ZR-OIT/senior-project/CST 472 - Winter/images/Trello after changes part 2 1-12-2021.png

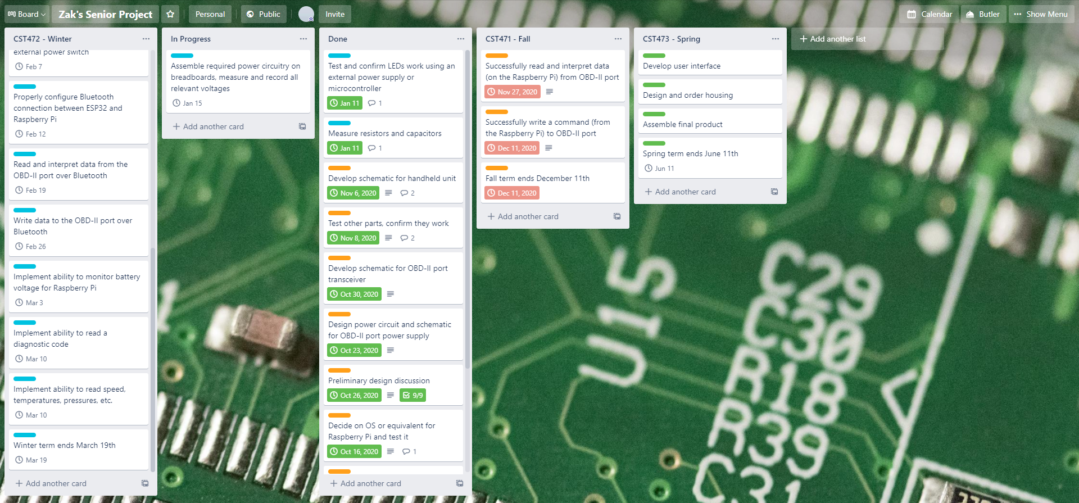
CST 472 - Winter/images/Trello after changes part 2 1-12-2021.png
