ZR-OIT/senior-project/CST 472 - Winter/images/Trello after building circuit.png

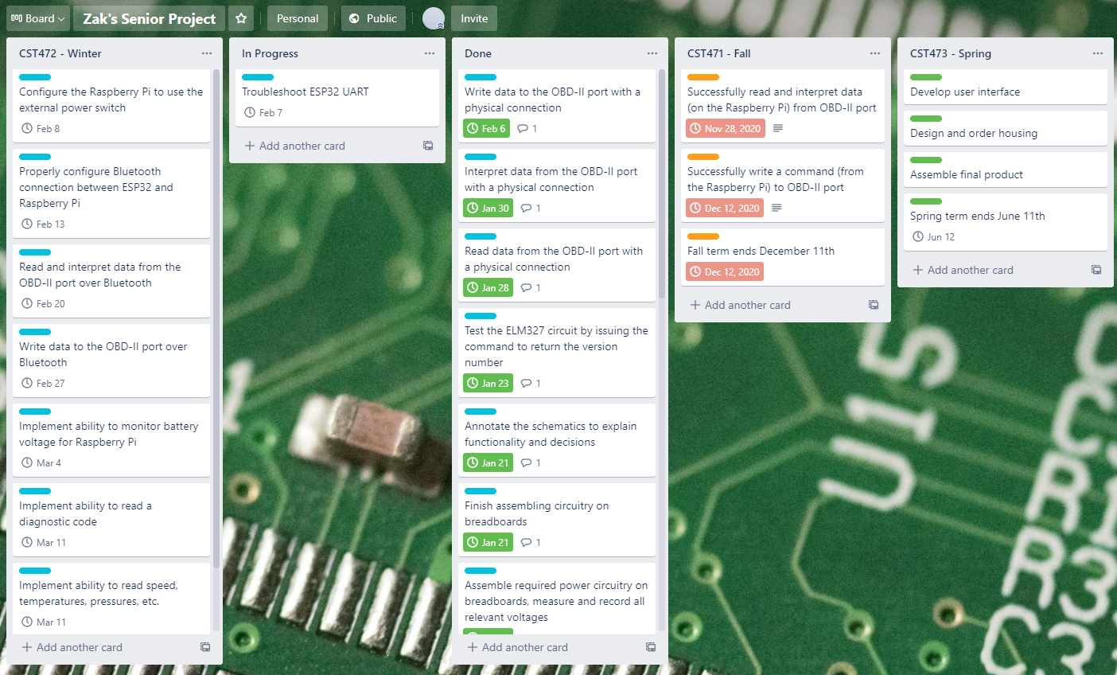
CST 472 - Winter/images/Trello after building circuit.png
