ZR-OIT/senior-project/README.md

# senior-project
My senior project for Oregon Institute of Technology - A touchscreen Bluetooth OBD-II diagnostic tool.
