ZR-OIT/senior-project/CST 472 - Winter/Memo 1.pdf

## CST 472

# Memo

To: | Kevin Pintong
From: | Zak Rowland
Date: | January 23, 2021
Re: | Memo 1

After last term ended, I wasn’t working on the project for almost a month as I was visiting family. Once the term started again, I would dive back into the project. But, motivation has been extremely hard to come by, and not just in this class. The first thing I worked on was testing resistors and capacitors with a multimeter as well as the LEDs and push button. The push button I got for the Pi has a LED built in, so I tested the external LEDs using this button and an Arduino for power.

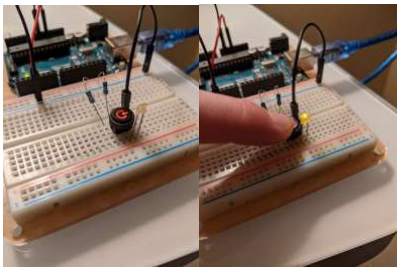
[picture p71: figure]

While testing and looking through my parts, I realized I forgot to order surface-mount to dualinline-pin adapters for my small ICs that will allow me to breadboard the circuit easier, so I ordered some. After meeting with you and discussing my schematic, I changed the 5V regulator to use a bigger input capacitor and began assembling the power delivery portions of the circuit. I built and tested the 12V to 5V circuitry first which worked as expected. I also attached breadboard wires to my OBD-II connector.

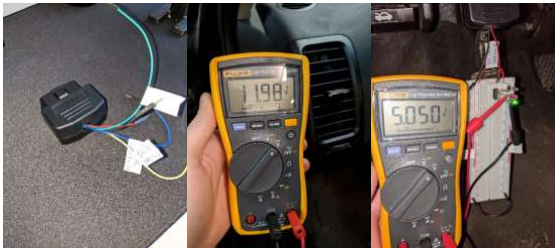
[picture p72: figure]

Once I had 5V power, I added and tested the 3.3V circuitry which also worked as expected.

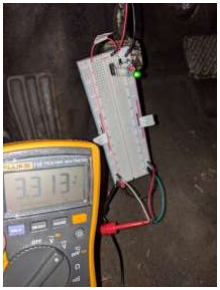
[picture p73: figure]

After I had the power circuitry, I began assembling the rest of the circuit. Once the SMD to DIP adapters came, I soldered them together with the ICs. I had trouble at first soldering the legs of the tiny 8-pin package (I used too much solder,) but eventually got the first side soldered and the other side went much smoother. The excess heat from messing up could have damaged the IC but it is unlikely.

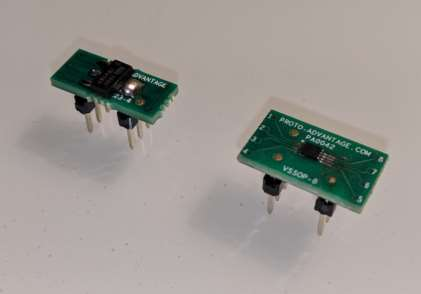
[picture p74: figure]

While building the circuit, I annotated the schematic to make sure myself and others understand how it functions and what things are for.

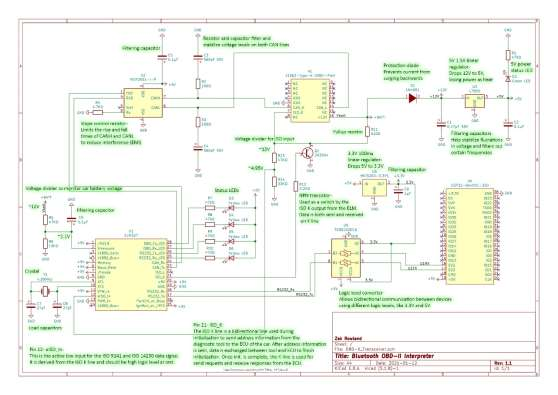
[picture p75: figure]

Once the circuit was assembled, I tried to test the ELM327 by reading the version number through a terminal. I used the UART of the ESP32 using the correct settings, however the data being read is complete gibberish, so I cannot confirm the circuit works yet. One good sign is that the four status LEDs light up in sequence when power is provided to the circuit, which as explained in the ELM327 datasheet means the chip is initializing.

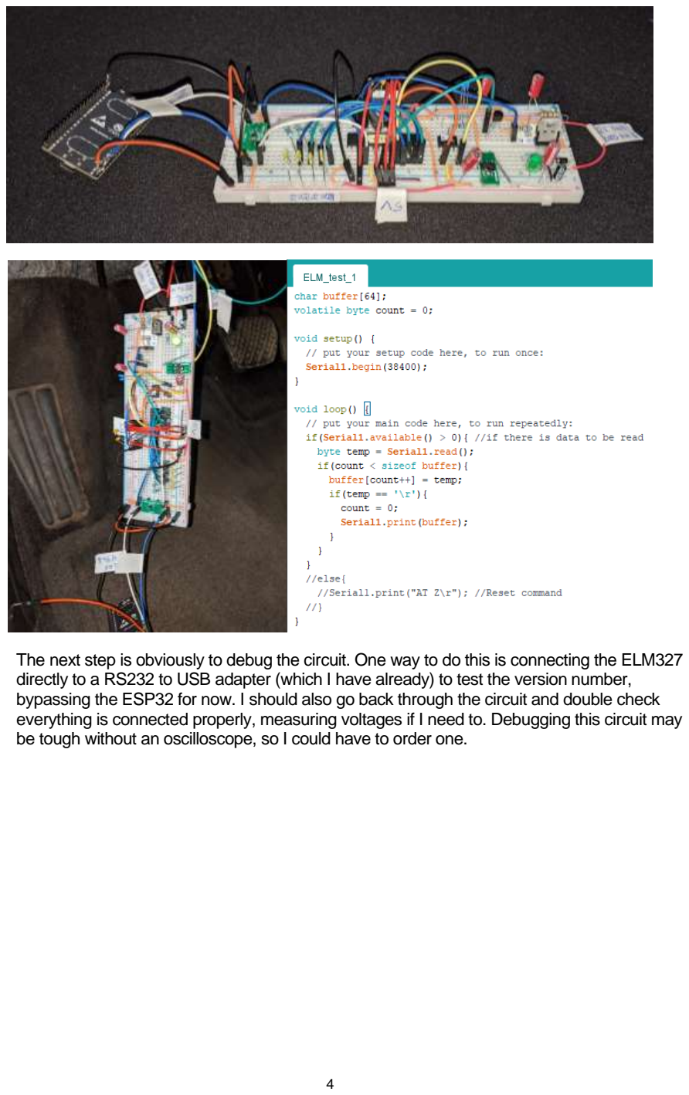
[picture p76: page 4]

The next step is obviously to debug the circuit. One way to do this is connecting the ELM327 directly to a RS232 to USB adapter (which I have already) to test the version number, bypassing the ESP32 for now. I should also go back through the circuit and double check everything is connected properly, measuring voltages if I need to. Debugging this circuit may be tough without an oscilloscope, so I could have to order one.

Hours worked since term start: 14

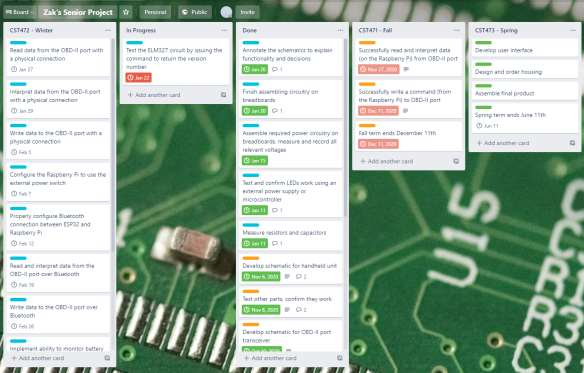
[picture p77: figure]

https://trello.com/b/57kp2fr0/zaks-senior-project
