ZR-OIT/senior-project/CST 374 - Proposal/Senior Project Gantt.xlsx

Wireless OBD-II Diagnostic Tool with Touchscreen
Select a period to highlight at right. A legend describing the charting follows. |  |  |  |  | Period Highlight: | 2 |  |  | Plan Duration |  |  |  |  |  | Actual Start |  |  |  |  | % Complete |  |  |  |  | Actual (beyond plan) |  |  |  |  |  |  |  | % Complete (beyond plan)
ACTIVITY | PLAN START | PLAN DURATION | ACTUAL START | ACTUAL DURATION | PERCENT COMPLETE | 2020-05-01 | 2020-06-01 | 2020-07-01 | 2020-08-01 | 2020-09-01 | 2020-10-01 | 2020-11-01 | 2020-12-01 | 2021-01-01 | 2021-02-01 | 2021-03-01 | 2021-04-01 | 2021-05-01 | 2021-06-01
 |  |  |  |  |  | 1 | 2 | 3 | 4 | 5 | 6 | 7 | 8 | 9 | 10 | 11 | 12 | 13 | 14 | 15 | 16 | 17 | 18 | 19 | 20 | 21 | 22 | 23 | 24 | 25 | 26 | 27 | 28 | 29 | 30 | 31 | 32 | 33 | 34 | 35 | 36 | 37 | 38 | 39 | 40 | 41 | 42 | 43 | 44 | 45 | 46 | 47 | 48 | 49 | 50 | 51 | 52 | 53
Documentation | 1 | 14 | 1 | 2 | 10%
Requirements Development | 1 | 5 | 1 | 2 | 80%
Research | 2 | 12 | 2 | 1 | 10%
Develop OBD-II Port Module | 4 | 10 | 0 | 0 | 0%
Testing | 5 | 10 | 0 | 0 | 0%
Develop Handheld Unit | 6 | 8 | 0 | 0 | 0%
Develop User Interface | 8 | 7 | 0 | 0 | 0%
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
