ZR-OIT/senior-project/CST 471 - Fall/images/Handheld Transceiver Schematic-1.jpg

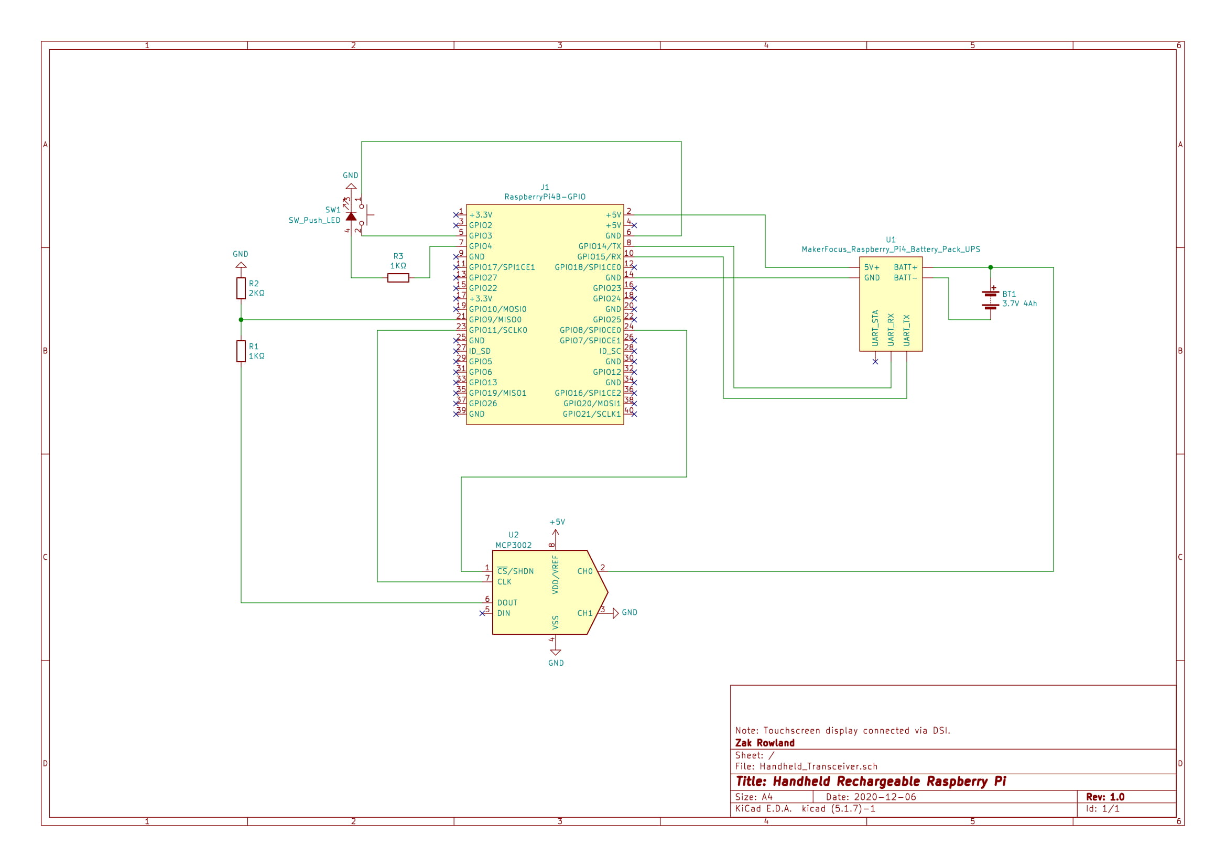
CST 471 - Fall/images/Handheld Transceiver Schematic-1.jpg
