ZR-OIT/senior-project/CST 471 - Fall/images/obd2 port pinout.png

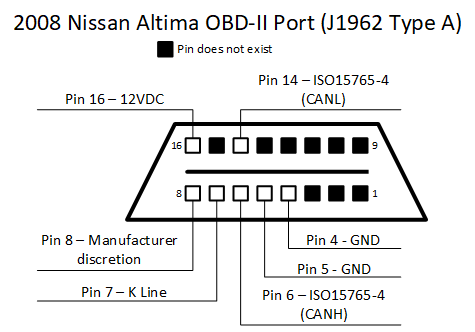
CST 471 - Fall/images/obd2 port pinout.png
