ZR-OIT/senior-project/CST 471 - Fall/images/OBD2.png

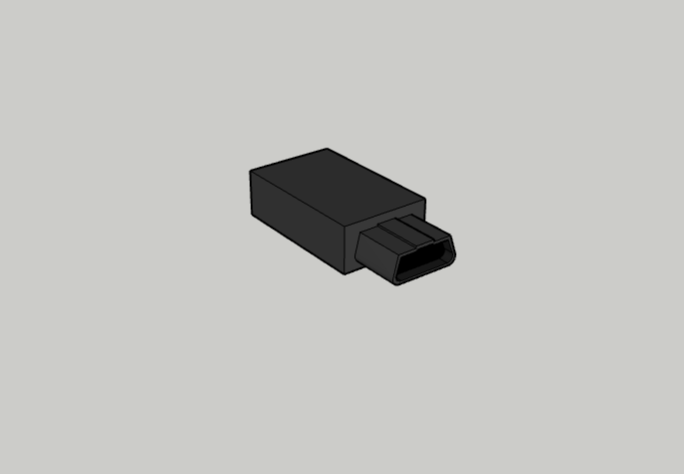
CST 471 - Fall/images/OBD2.png
