ZR-OIT/senior-project/CST 471 - Fall/images/screen.jpg

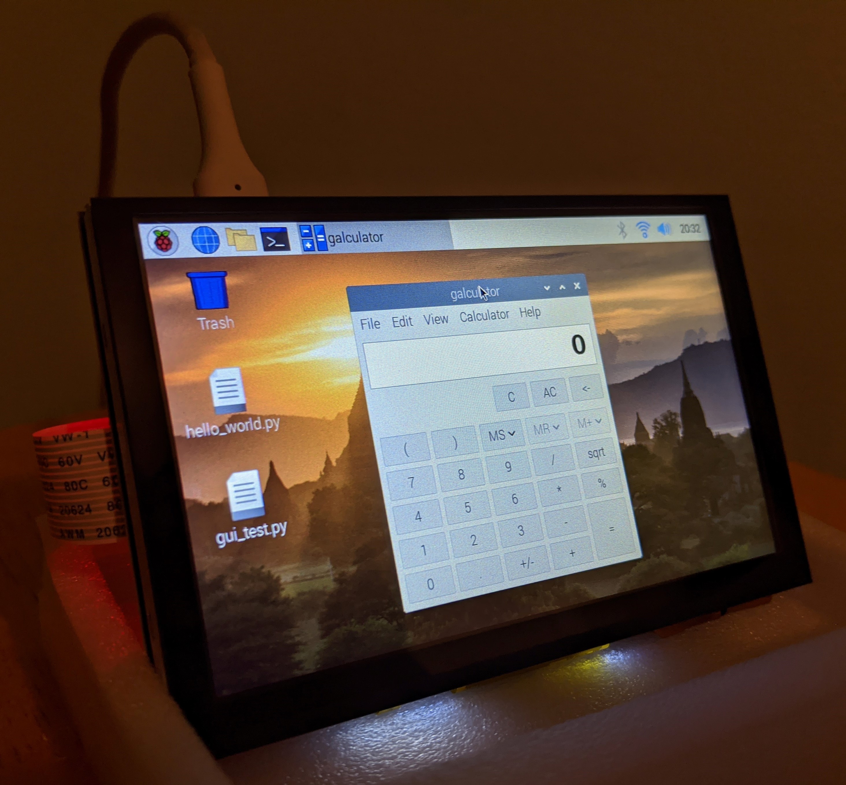
CST 471 - Fall/images/screen.jpg
