ZR-OIT/senior-project/CST 472 - Winter/images/3-8-2021 ble phone app.png

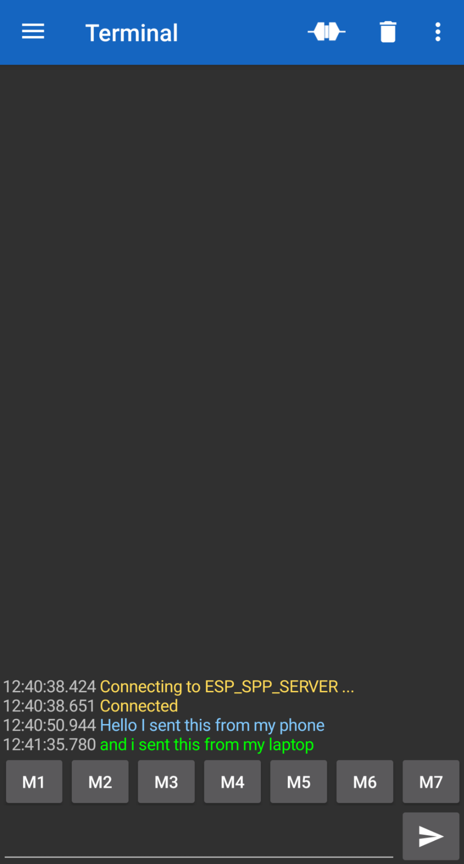
CST 472 - Winter/images/3-8-2021 ble phone app.png
