ZR-OIT/senior-project/CST 472 - Winter/images/3-8-2021 esp server info.png

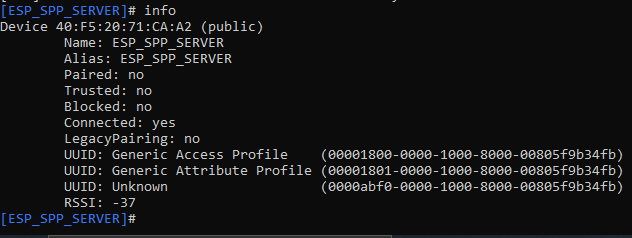
CST 472 - Winter/images/3-8-2021 esp server info.png
