ZR-OIT/senior-project/CST 472 - Winter/images/3-8-2021 pairing esp to pi from terminal.png

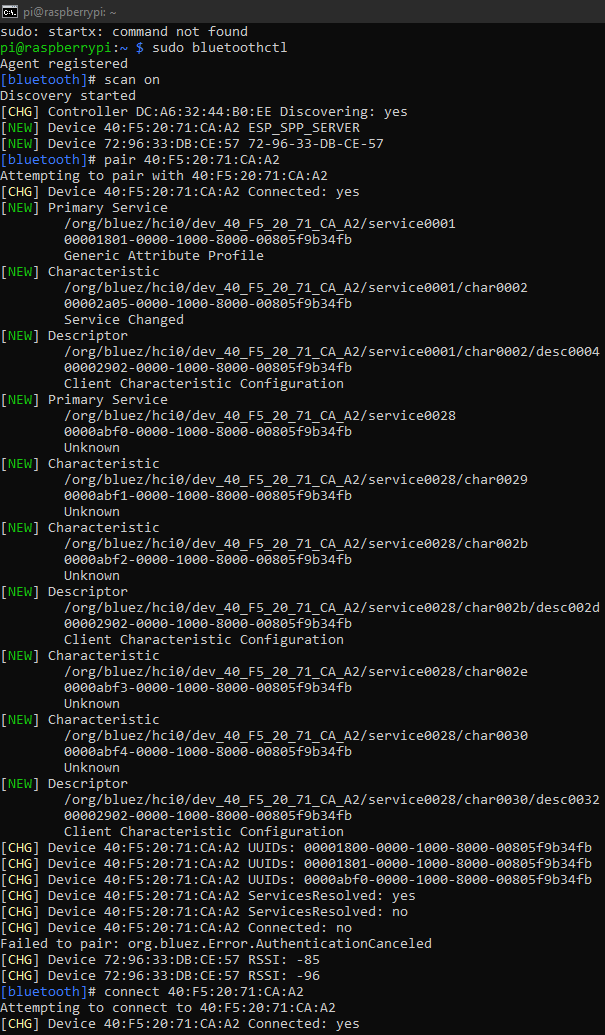
CST 472 - Winter/images/3-8-2021 pairing esp to pi from terminal.png
