ZR-OIT/senior-project/CST 472 - Winter/images/3-9-2021 trello.png

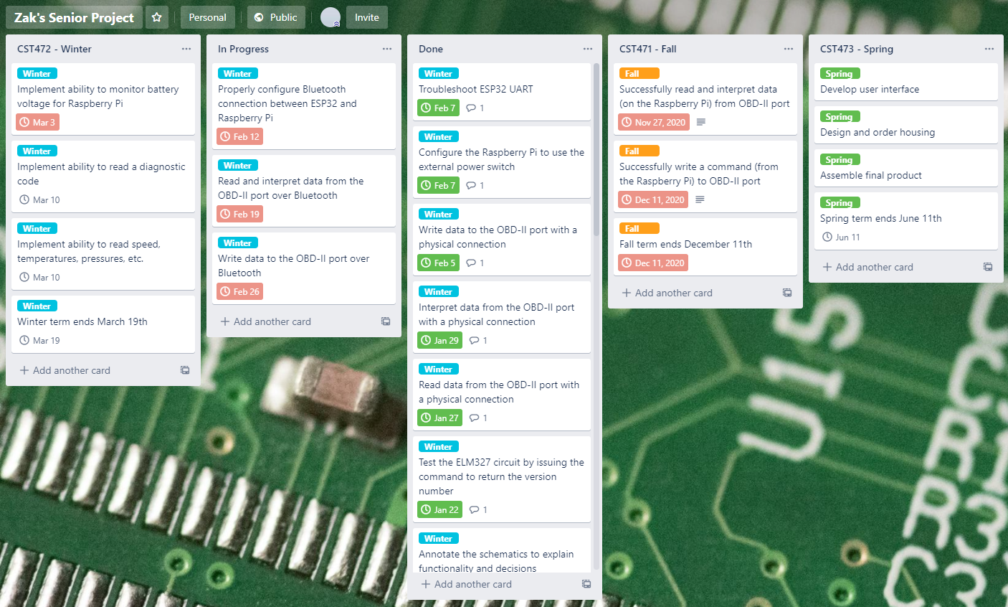
CST 472 - Winter/images/3-9-2021 trello.png
