ZR-OIT/senior-project/CST 472 - Winter/images/3-28-2021-UPS1.jpg

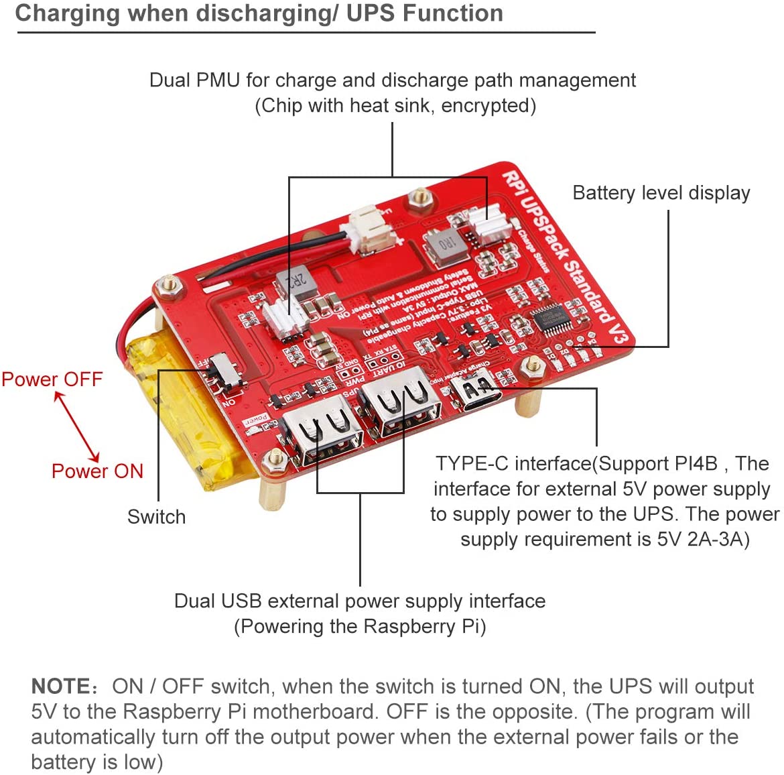
CST 472 - Winter/images/3-28-2021-UPS1.jpg
