ZR-OIT/senior-project/CST 472 - Winter/images/ELM other commands.png

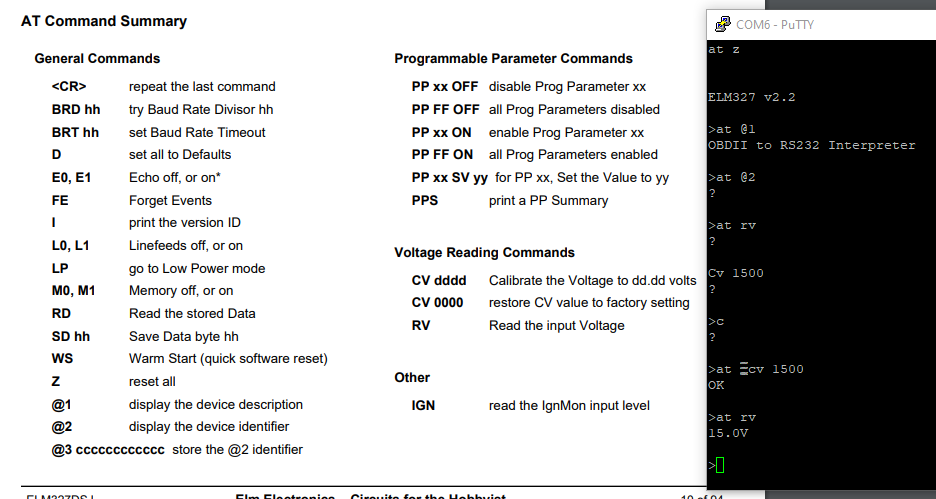
CST 472 - Winter/images/ELM other commands.png
