ZR-OIT/senior-project/CST 472 - Winter/images/Gibberish data through ESP.png

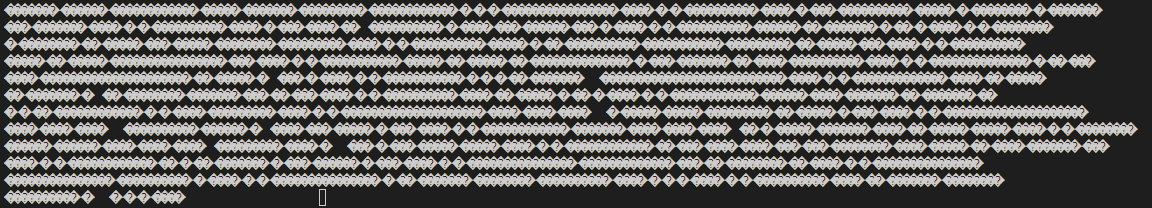
CST 472 - Winter/images/Gibberish data through ESP.png
