ZR-OIT/senior-project/CST 472 - Winter/images/PXL_20210112_045008964.jpg

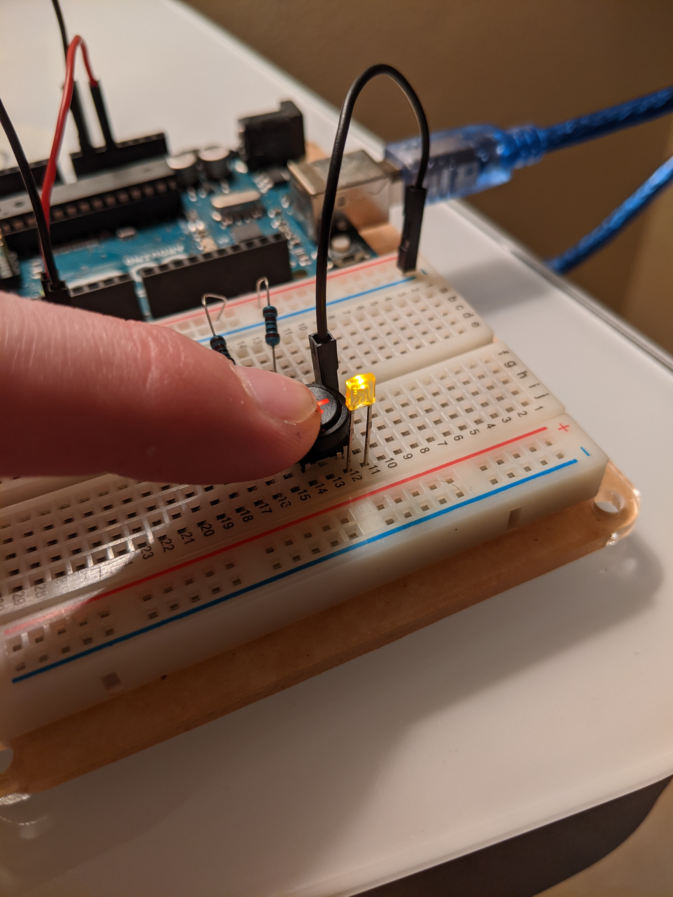
CST 472 - Winter/images/PXL_20210112_045008964.jpg
