ZR-OIT/senior-project/CST 472 - Winter/images/PXL_20210121_015945303.jpg

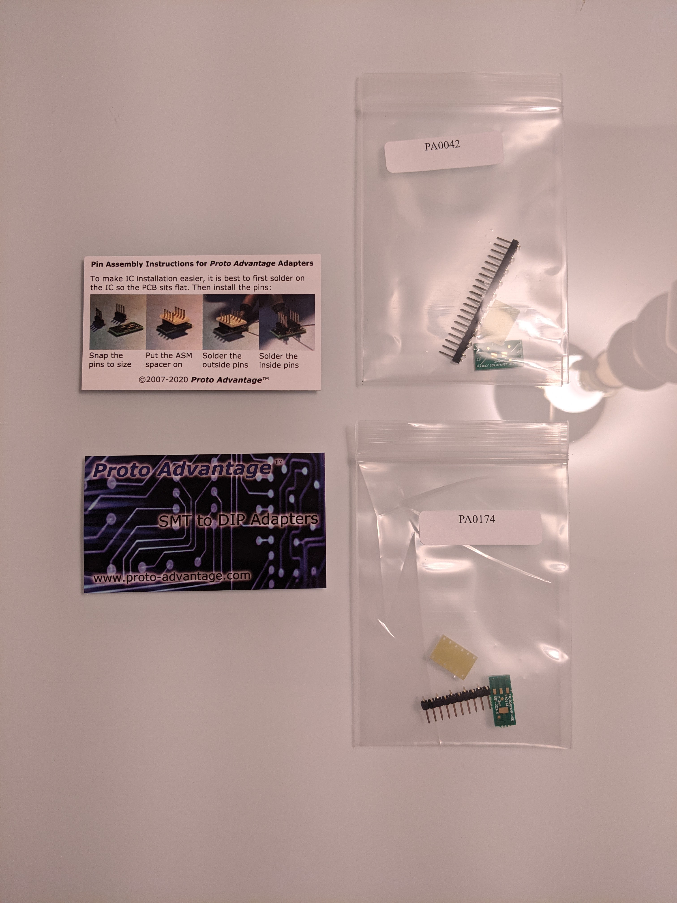
CST 472 - Winter/images/PXL_20210121_015945303.jpg
