ZR-OIT/senior-project/CST 472 - Winter/images/PXL_20210121_030754074.jpg

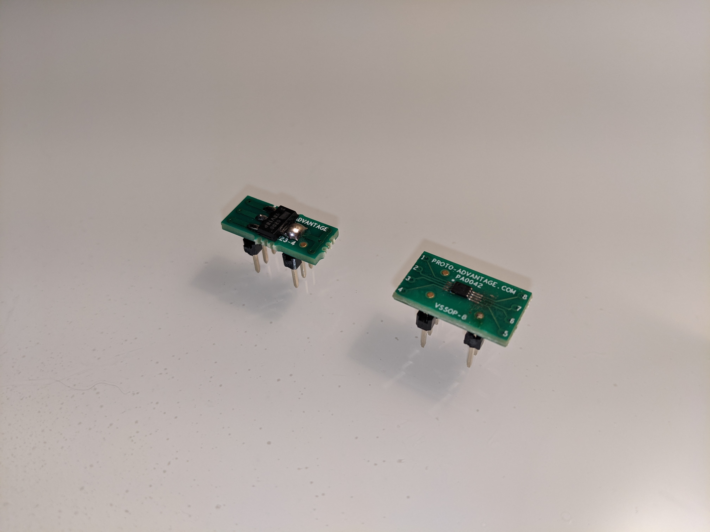
CST 472 - Winter/images/PXL_20210121_030754074.jpg
