ZR-OIT/senior-project/CST 472 - Winter/images/PXL_20210215_024756749_esp32-3V-out.jpg

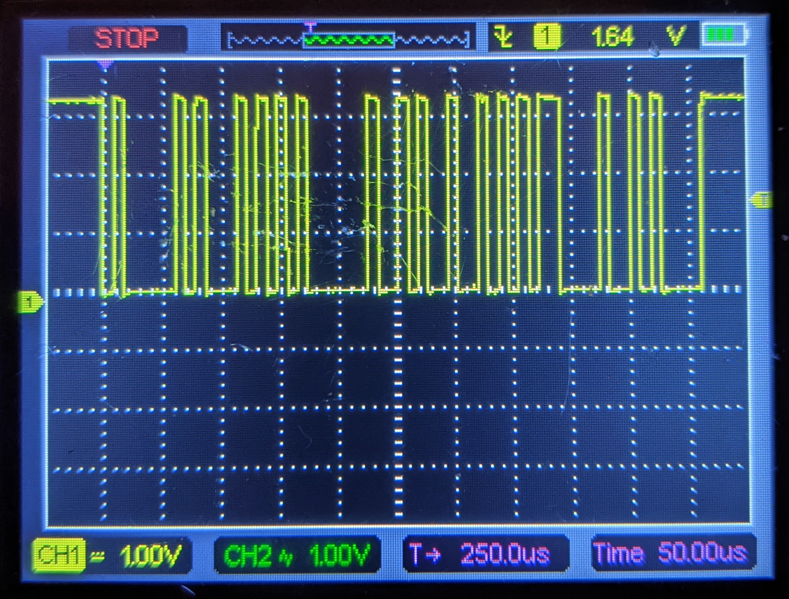
CST 472 - Winter/images/PXL_20210215_024756749_esp32-3V-out.jpg
