ZR-OIT/senior-project/CST 472 - Winter/images/PXL_20210215_025533629_signal-after-3V-to-5V-conversion.jpg

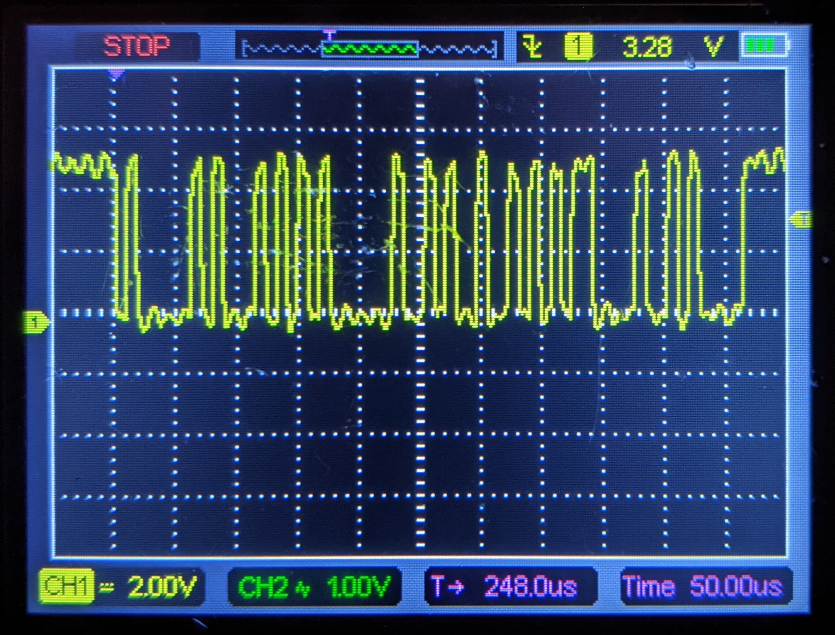
CST 472 - Winter/images/PXL_20210215_025533629_signal-after-3V-to-5V-conversion.jpg
