ZR-OIT/senior-project/CST 472 - Winter/images/talking to car 2.png

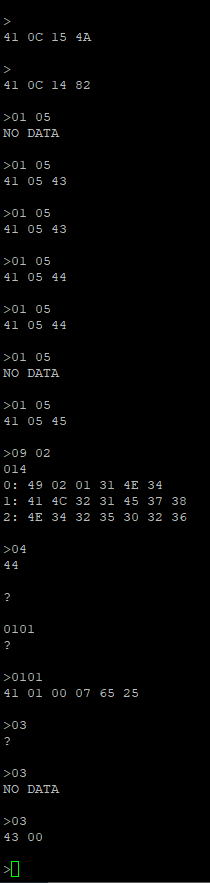
CST 472 - Winter/images/talking to car 2.png
