ZR-OIT/senior-project/CST 473 - Spring/Touchscreen GUI.jpg

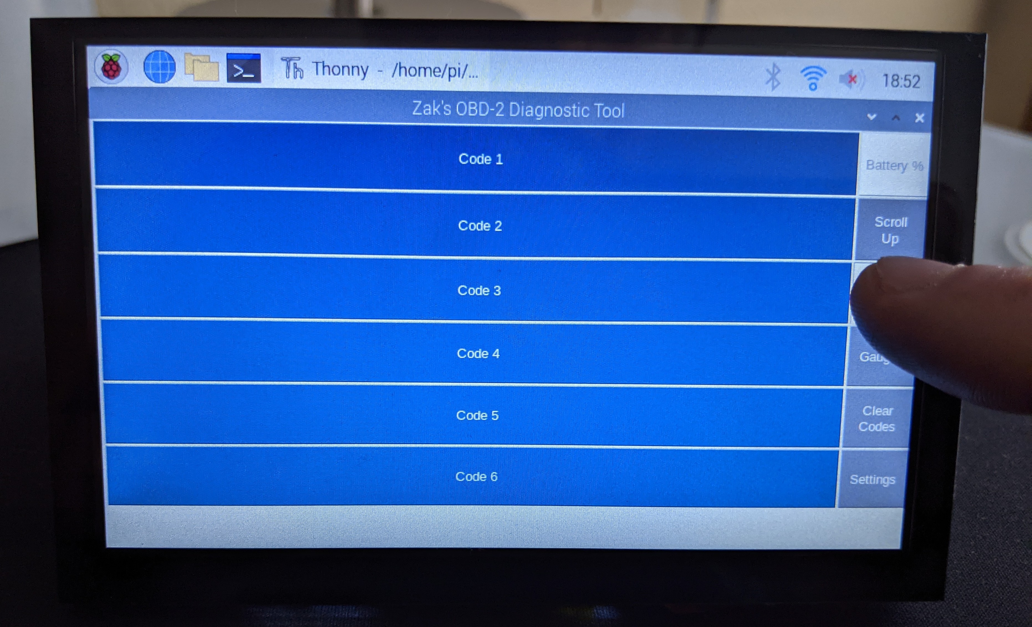
CST 473 - Spring/Touchscreen GUI.jpg
