ZR-OIT/senior-project/CST 471 - Fall/Parts Table - Created 10-3-2020.xlsx

Zak Rowland's Senior Project Part List - Last Updated 12/6/2020
Handheld Module | Part Name: | Links to Buy: | Cost Each: | Quantity: | Spares: | Shipping Cost: | Total Cost: | Purchased: | Datasheets: | Total Parts Cost: | $114.80
 | Raspberry Pi 4 (Model B) | https://www.adafruit.com/product/4292 | $35.00 | 1 | 0 | $0.00 | $0.00 | Already had. | https://www.raspberrypi.org/documentation/ | Total Parts Cost with Shipping: | $124.64
 | OSOYOO 5" DSI Display | https://www.amazon.com/gp/product/B07KKB5YS9 | $43.88 | 1 | 0 | $0.00 | $43.88 | Yes | N/A | Total Parts Cost to Me: | $89.44
 | MakerFocus Raspberry Pi 4 Battery Pack UPS | https://www.amazon.com/dp/B01LAEX7J0/ | $23.99 | 1 | 0 | $0.00 | $23.99 | Yes | https://drive.google.com/file/d/12_UCy6u5iaznpgSu-4YFTY0w-D2REM_4/view | Total Parts Cost to Me with Shipping: | $99.28
 | Momentary Switch | https://www.adafruit.com/product/3104 | $1.95 | 1 | 0 | $4.85 | $6.80 | Yes | https://cdn-shop.adafruit.com/product-files/3104/C4819+datasheet.pdf | Total Shipping Cost: | $9.84
 | MCP3002 ADC | https://www.digikey.com/short/zvhjjh | $1.79 | 1 | 0 | $4.99 | $6.78 | Yes | https://ww1.microchip.com/downloads/en/DeviceDoc/21294E.pdf
 | 1KΩ Resistor | https://www.digikey.com/short/zvhj4t | $0.10 | 2 | 0 | $0.00 | $0.00 | Already had. | https://www.seielect.com/catalog/sei-rnf_rnmf.pdf
 | 2KΩ Resistor | https://www.digikey.com/short/zvwbrp | $0.10 | 1 | 0 | $0.00 | $0.00 | Already had. | https://www.seielect.com/catalog/sei-rnf_rnmf.pdf
 | Samsung 32GB MicroSD | Fred Meyer | $7.99 | 1 | 0 | $0.00 | $7.99 | Yes | N/A
OBD-II Module | Part Name: | Links to Buy: | Cost Each: | Quantity: | Spares: | Shipping Cost: | Total Cost: | Purchased: | Datasheets: | Total Parts Cost: | $34.11
 | ELM327 (OBD-II to RS232) | https://www.elmelectronics.com/ic/elm327/ | $16.00 | 1 | 0 | $6.10 | $22.10 | Yes | https://www.elmelectronics.com/wp-content/uploads/2017/01/ELM327DS.pdf | Total Parts Cost with Shipping: | $51.20
 | ESP32-DevKitC-32D | https://www.digikey.com/short/zvch2v | $10.00 | 1 | 0 | $10.99 | $20.99 | Yes | https://www.espressif.com/sites/default/files/documentation/esp32_datasheet_en.pdf | Total Parts Cost to Me: | $35.42
 | 100Ω 1/4W Resistor | https://www.digikey.com/short/zvcbd9 | $0.10 | 2 | 1 | $0.00 | $0.30 | Yes | https://www.seielect.com/catalog/sei-rnf_rnmf.pdf | Total Parts Cost to Me with Shipping: | $52.51
 | 470Ω 1/4W Resistor | https://www.digikey.com/short/zvcb0v | $0.07 | 5 | 5 | $0.00 | $0.65 | Yes | https://www.seielect.com/catalog/sei-rnf_rnmf.pdf | Total Shipping Cost: | $17.09
 | 510Ω 1/2W Resistor | https://www.digikey.com/short/zvcb18 | $0.10 | 1 | 1 | $0.00 | $0.20 | Yes | https://www.seielect.com/catalog/sei-cf_cfm.pdf
 | 2.2KΩ 1/4W Resistor | https://www.digikey.com/short/zvc570 | $0.10 | 1 | 1 | $0.00 | $0.20 | Yes | https://www.seielect.com/catalog/sei-rnf_rnmf.pdf
 | 4.7KΩ 1/4W Resistor | https://www.digikey.com/short/zvc537 | $0.10 | 1 | 1 | $0.00 | $0.20 | Yes | https://www.seielect.com/catalog/sei-rnf_rnmf.pdf
 | 10KΩ 1/4W Resistor | https://www.digikey.com/short/zvc5qc | $0.10 | 1 | 1 | $0.00 | $0.20 | Yes | https://www.seielect.com/catalog/sei-rnf_rnmf.pdf
 | 33KΩ 1/4W Resistor | https://www.digikey.com/short/zvc582 | $0.10 | 1 | 1 | $0.00 | $0.20 | Yes | https://www.seielect.com/catalog/sei-rnf_rnmf.pdf
 | 47KΩ 1/4W Resistor | https://www.digikey.com/short/zvc5j0 | $0.10 | 2 | 1 | $0.00 | $0.30 | Yes | https://www.seielect.com/catalog/sei-rnf_rnmf.pdf
 | 27pF 50V Capacitor | https://www.digikey.com/short/zvcf0n | $0.22 | 2 | 1 | $0.00 | $0.66 | Yes | https://www.vishay.com/docs/45171/kseries.pdf
 | 560pF 50V Capacitor | https://www.digikey.com/short/zvc27m | $0.24 | 2 | 1 | $0.00 | $0.72 | Yes | https://product.tdk.com/info/en/catalog/datasheets/leadmlcc_halogenfree_fg_en.pdf?ref_disty=digikey
 | 0.1uF 50V Capacitor | https://www.digikey.com/short/zvc28j | $0.10 | 4 | 1 | $0.00 | $0.50 | Yes | https://katalog.we-online.de/pbs/datasheet/860020672001.pdf
 | 1uF 50V Capacitor | https://www.digikey.com/short/zvc2jf | $0.10 | 1 | 1 | $0.00 | $0.20 | Yes | https://katalog.we-online.de/pbs/datasheet/860020672005.pdf
 | 1N4001 Diode | https://www.digikey.com/short/zvc245 | $0.10 | 1 | 1 | $0.00 | $0.20 | Yes | https://www.comchiptech.com/admin/files/product/1N4001-G%20Thru.%201N4007-G%20RevB.pdf
 | Green LED | https://www.digikey.com/short/zvc29p | $0.33 | 1 | 1 | $0.00 | $0.00 | Already had. | http://www.kingbrightusa.com/images/catalog/SPEC/WP7113GD.pdf
 | Yellow LED | https://www.digikey.com/short/zvc2f7 | $0.21 | 4 | 1 | $0.00 | $0.00 | Already had. | https://katalog.we-online.de/led/datasheet/151051YS04000.pdf
 | 2N3904 NPN | https://www.digikey.com/short/zvc2dt | $0.20 | 1 | 1 | $0.00 | $0.40 | Yes | https://www.onsemi.com/pub/Collateral/PZT3904-D.pdf
 | MCP2551 Transceiver | https://www.digikey.com/short/zvc204 | $1.09 | 1 | 0 | $0.00 | $1.09 | Yes | http://www.microchip.com/mymicrochip/filehandler.aspx?ddocname=en011797
 | L7805 Regulator | https://www.digikey.com/short/zvc2v9 | $0.50 | 1 | 1 | $0.00 | $1.00 | Yes | http://www.st.com/content/ccc/resource/technical/document/datasheet/41/4f/b3/b0/12/d4/47/88/CD00000444.pdf/files/CD00000444.pdf/jcr:content/translations/en.CD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
 | TXB0102DCUR | https://www.digikey.com/short/zvcw72 | $0.71 | 1 | 0 | $0.00 | $0.71 | Yes | http://www.ti.com/general/docs/suppproductinfo.tsp?distId=10
 | MIC5200-3.3 | https://www.digikey.com/short/zvcwtw | $1.03 | 1 | 0 | $0.00 | $1.03 | Yes | http://www.microchip.com/mymicrochip/filehandler.aspx?ddocname=en579592
 | 4.00MHz crystal | https://www.digikey.com/short/zvcw3m | $0.66 | 1 | 0 | $0.00 | $0.66 | Yes | http://www.ecsxtal.com/store/pdf/hc-49usx.pdf
 | J1962-TypeA connector | https://www.ebay.com/itm/DIY-Universal-16-Pin-OBD2-Male-Connector-Cable-Adapter-Terminal-Diagnostic-Tool/154042663449 | $2.49 | 1 | 0 | $0.00 | $2.49 | Yes | N/A
Other | Part Name: | Links to Buy: | Cost Each: | Quantity: | Spares: | Shipping Cost: | Total Cost: | Purchased: | Datasheets:
