ZR-OIT/senior-project/CST 472 - Winter/Resistor and capacitor measurements.xlsx

Resistor and capacitor measurements
CST 472 - 1/11/2020 | OBD-II Transceiver
8:00PM to | Resistors |  |  | Capacitors
 | Name | Value | Actual | Name | Value | Actual
 | R1 | 470Ω | 467.6 | C1 | 0.1μF 50V | 0.095μF
 | R2 | 100Ω | 99.6 | C2 | 0.1μF | 0.096μF
 | R3 | 100Ω | 99.6 | C3 | 560pF 50V | ?
 | R4 | 4.7KΩ | 4.672k | C4 | 560pF 50V | ?
 | R5 | 47KΩ | 46.87k | C5 | 0.1μF | 0.094μF
 | R6 | 10KΩ | 9.94k | C6 | 0.1μF | 0.096μF
 | R7 | 470Ω | 468.3 | C7 | 27pF | ?
 | R8 | 470Ω | 467.9 | C8 | 27pF | ?
 | R9 | 470Ω | 468 | C9 | 1μF | 1.04μF
 | R10 | 470Ω | 468.1
 | R11 | 510Ω 1/2W | 504.5
 | R12 | 2.2KΩ | 2.185k
 | R13 | 47KΩ | 46.86k
 | R14 | 33KΩ | 32.91k
 | Handheld
 | Resistors |  |  | Capacitors
 | Name | Value | Actual | Name | Value | Actual
 | R1 | 1KΩ | 0.997k
 | R2 | 2KΩ | 2.025k
 | R3 | 1KΩ | 0.998k
