ZR-OIT/senior-project/CST 471 - Fall/Work deliverables results.pdf

## CST 471

# Memo

To: | Kevin Pintong
From: | Zak Rowland
Date: | December 8, 2020
Re: | Work deliverables result

Final score: 8 complete out of 12 = 66.67%

- COMPLETE. Choose an operating system for the Raspberry Pi and become familiar with it

On October 16th, I chose to install Raspberry Pi OS as the operating system. Pi OS is essentially a fork of Rasbian with the Pi Foundation’s configuration on top. I chose this OS because it is recommended for new Pi users, however changing operating systems would be trivial if it is necessary. I tried out all the included applications and checked out all the configuration settings too. I also completed a very simple Python GUI tutorial to get a feel for developing a user interface. See images below.

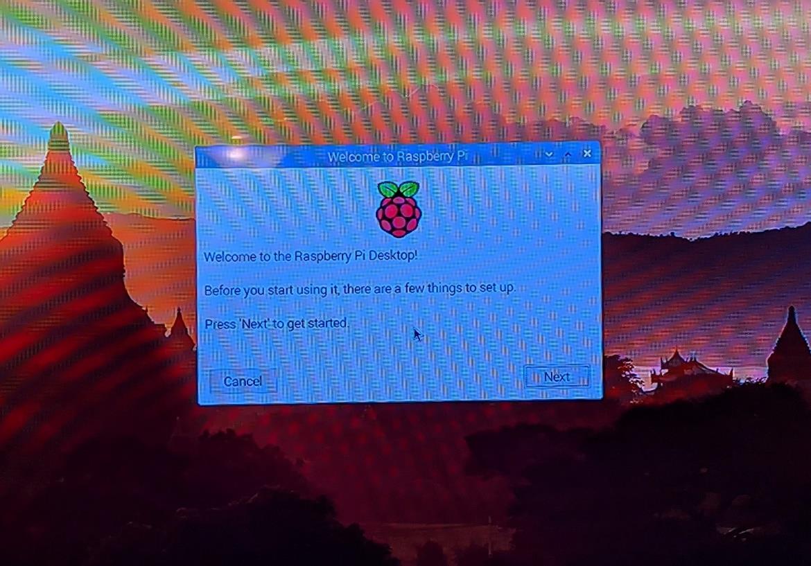
[picture p110: figure]
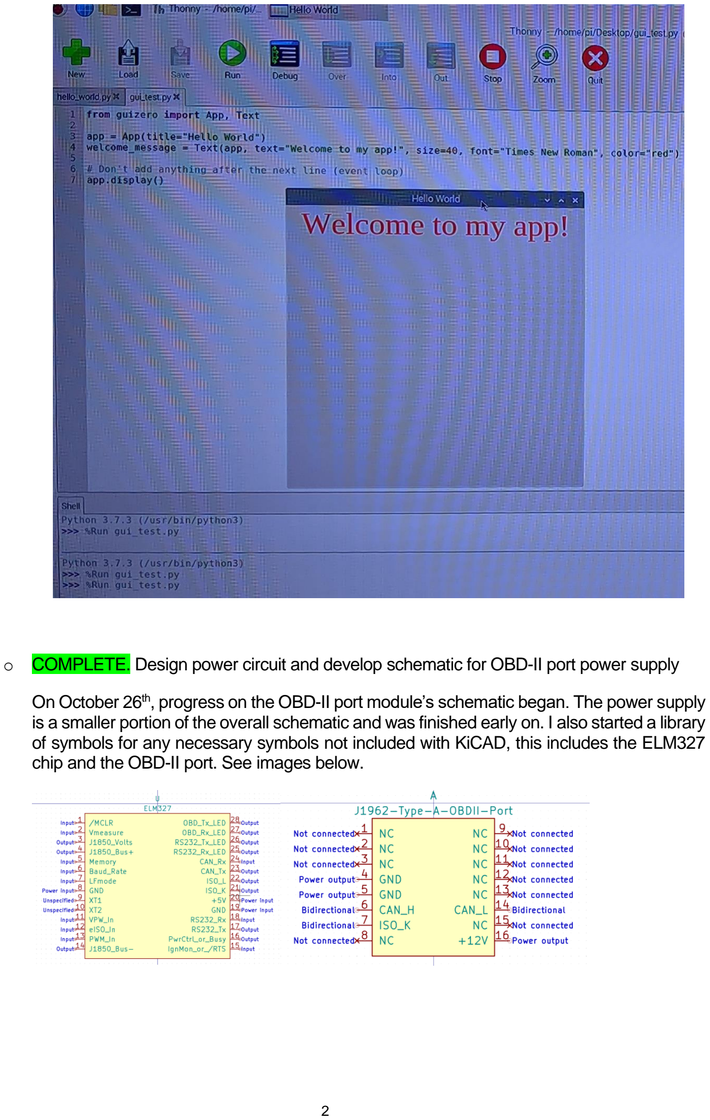
[picture p111: page 2]

- COMPLETE. Design power circuit and develop schematic for OBD-II port power supply

On October 26th, progress on the OBD-II port module’s schematic began. The power supply is a smaller portion of the overall schematic and was finished early on. I also started a library of symbols for any necessary symbols not included with KiCAD, this includes the ELM327 chip and the OBD-II port. See images below.

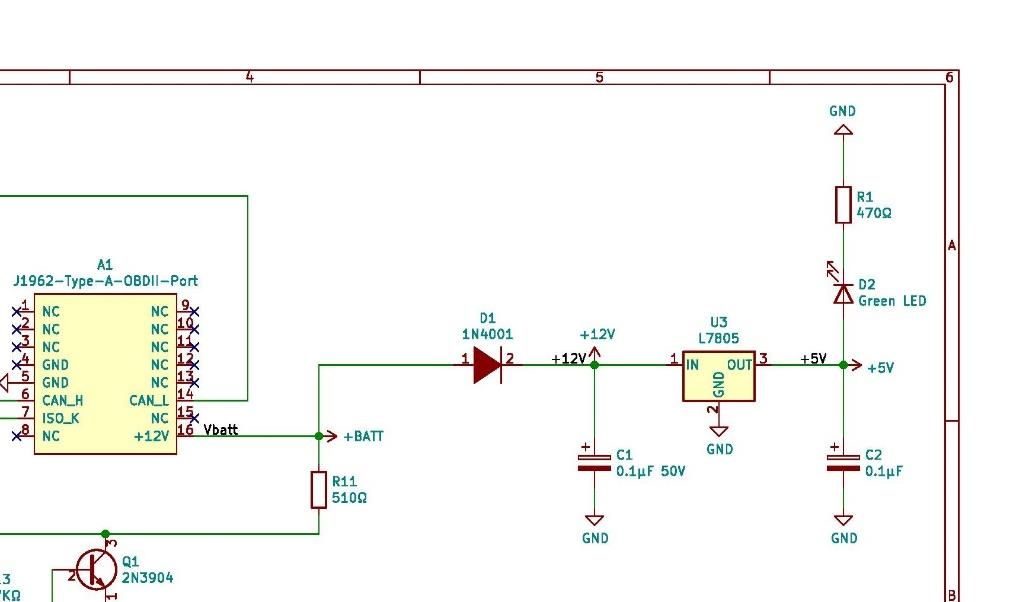
[picture p112: figure]

- | COMPLETE. | Develop schematic for OBD-II port transceiver (includes power supply
mentioned above)

After the power supply portion of the schematic was complete, the rest of it could be finished. One of the most difficult decisions was choosing a Bluetooth module to use. In the end it was worth researching all the different types, and the ESP32 is a perfect fit for the project. This schematic was completed on November 11th
| | . See final OBD-II port module schematic
and more symbols below.

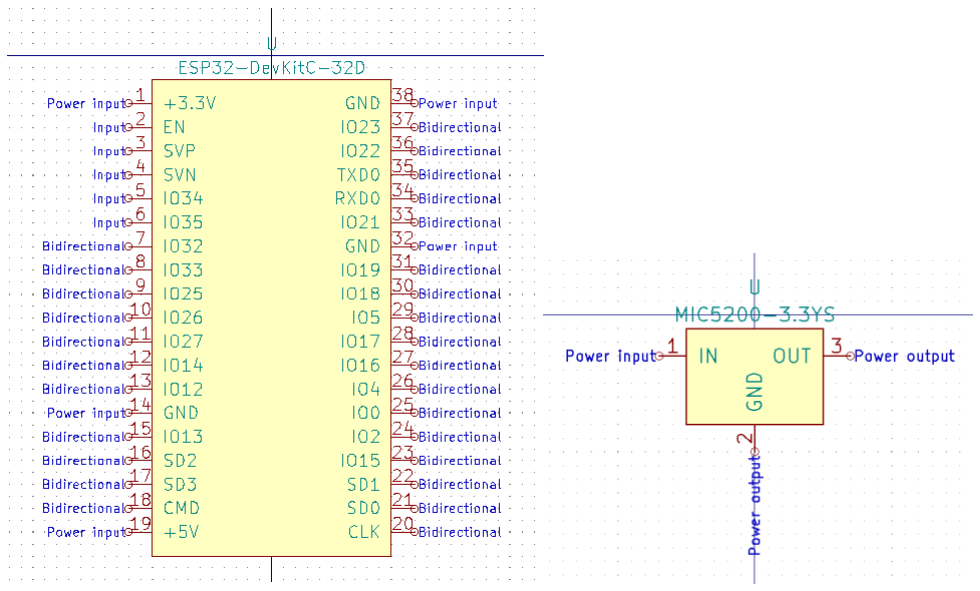
[picture p113: figure]
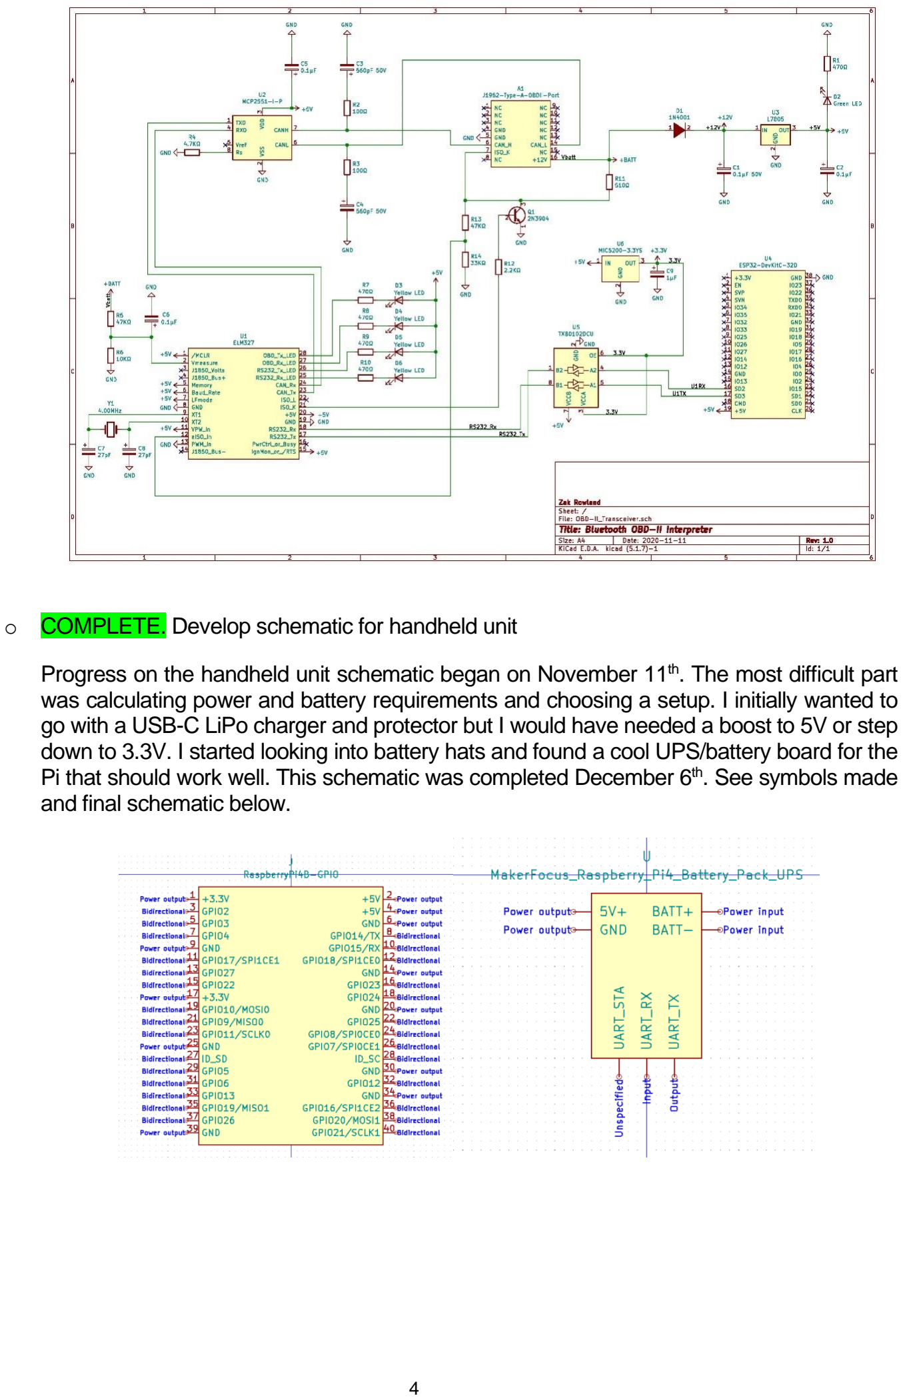
[picture p114: page 4]

- COMPLETE. Develop schematic for handheld unit

Progress on the handheld unit schematic began on November 11th
. The most difficult part
was calculating power and battery requirements and choosing a setup. I initially wanted to go with a USB-C LiPo charger and protector but I would have needed a boost to 5V or step down to 3.3V. I started looking into battery hats and found a cool UPS/battery board for the Pi that should work well. This schematic was completed December 6th
. See symbols made
and final schematic below.

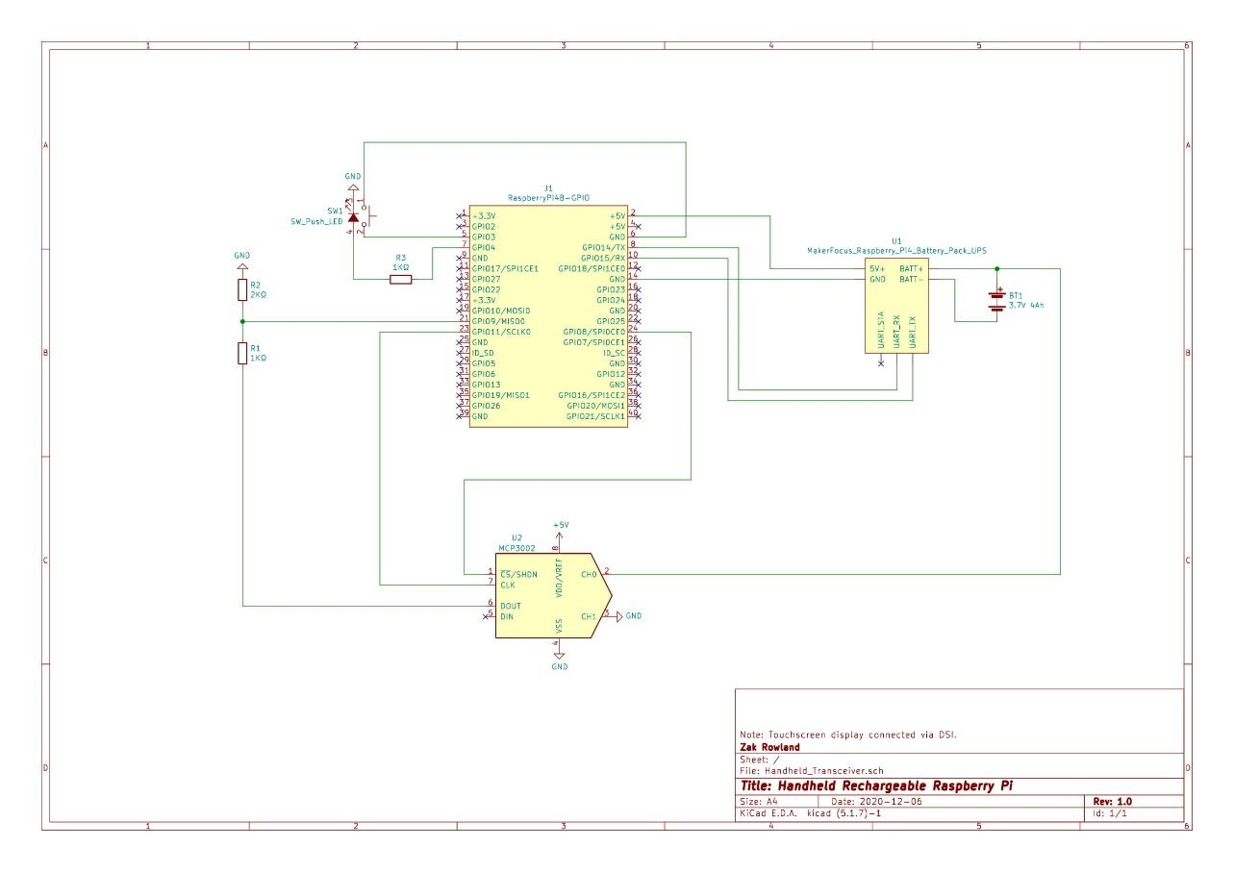
[picture p115: figure]

- COMPLETE. Order necessary parts.

I ordered all parts for OBD-II module first from Digi-Key, then once handheld unit was finished I ordered those parts from Amazon, Adafruit, and Digikey. See table of parts below.

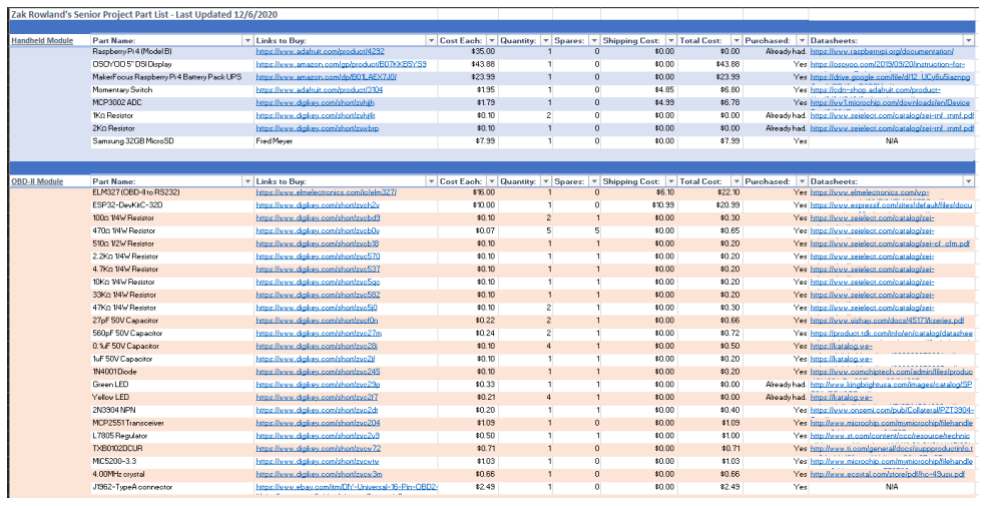
[picture p116: figure]

- | INCOMPLETE. | Test the ELM327 chip (there is a command to issue that will return the
version number if everything is working)

Testing the ELM327 requires most of the circuitry to be assembled already, and I do not have a multimeter yet to test all my components before connecting them. It was an oversight from the beginning of the term; I thought I could get more done than I really could. Now that I have actually made progress on the project, I will have be able to set more realistic goals
| going forward.

- COMPLETE. Connect touchscreen to Raspberry Pi and register a touch

The DSI display I chose was truly plug and play; I was able to boot up the Pi with the screen connected and navigate the OS by touch right away. A demo of the touch screen was provided during the design review, and see the image below of it connected.

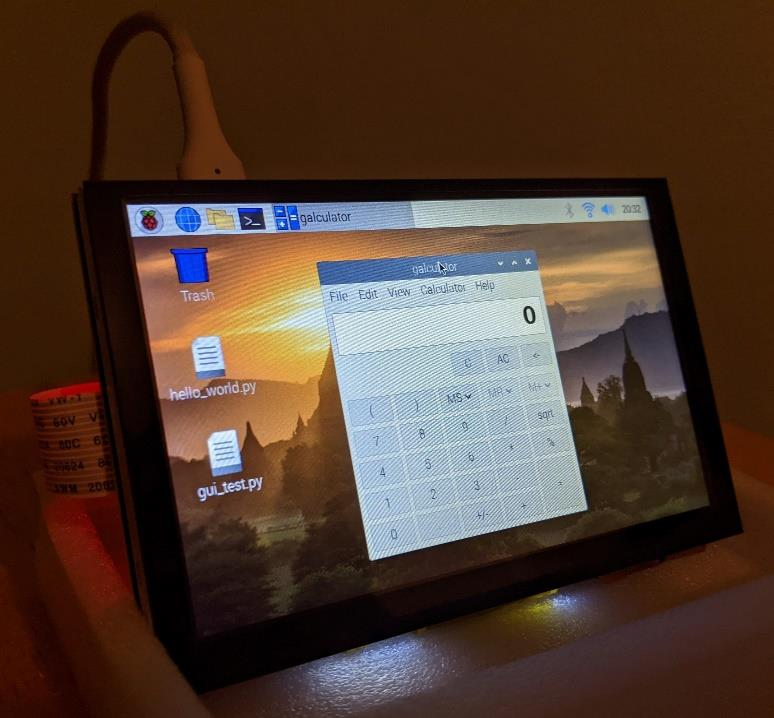
[picture p117: figure]

- COMPLETE. Configure the Bluetooth module (changing name, PIN, mode, etc.)

For the final design I decided to use Visual Studio Code with the official Espressif ESP32 extension. This provides more control over the hardware and includes functionality like a debugger and terminal. For the purposes of testing the Bluetooth functionality I used the Arduino IDE since the included Bluetooth examples are far less complex. This was completed December 5th
. I used my phone to verify the configuration worked, see images below.

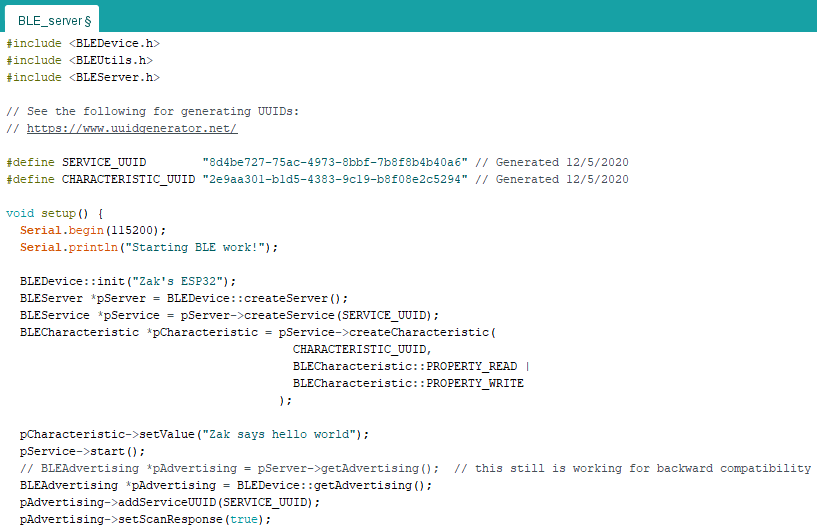
[picture p118: figure]

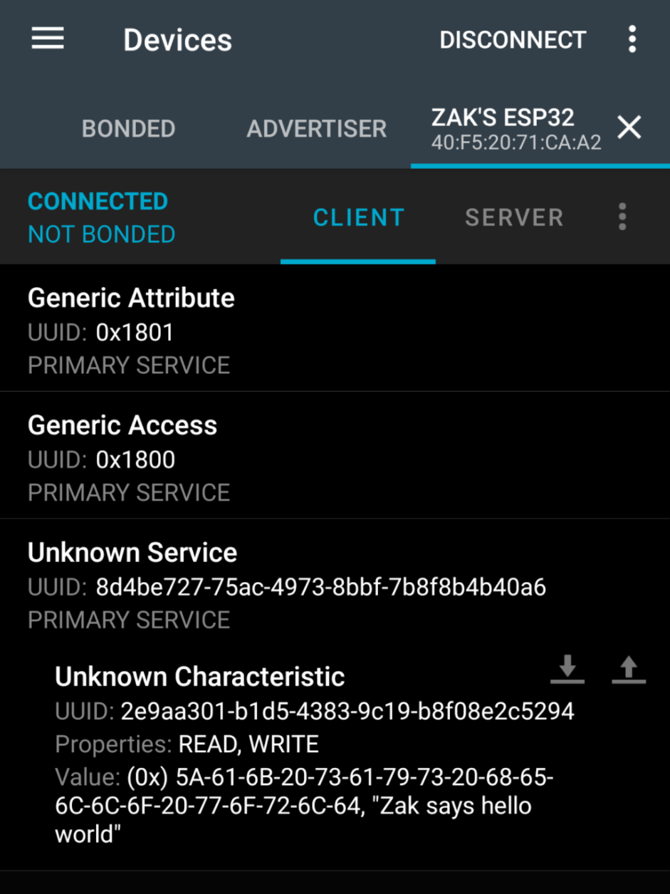
[picture p119: figure]

- COMPLETE. Establish a Bluetooth connection between Raspberry Pi and Bluetooth module

The Pi doesn’t include a Bluetooth stack out of the box, so I download BlueZ since it seemed to be popular. After some troubleshooting, I was able to see the ESP32 from the Pi and connect to it. The same characteristic value can be read (except in hex only) on the Pi that the phone read above (“Zak says hello world”). See images below.

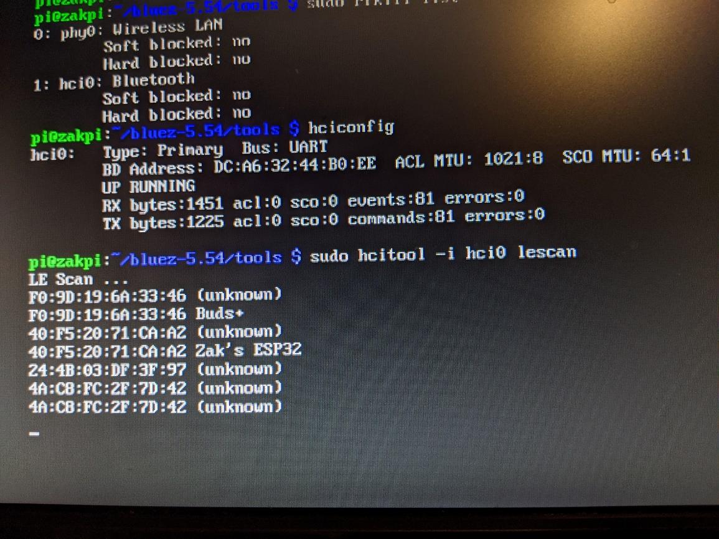
[picture p120: figure]
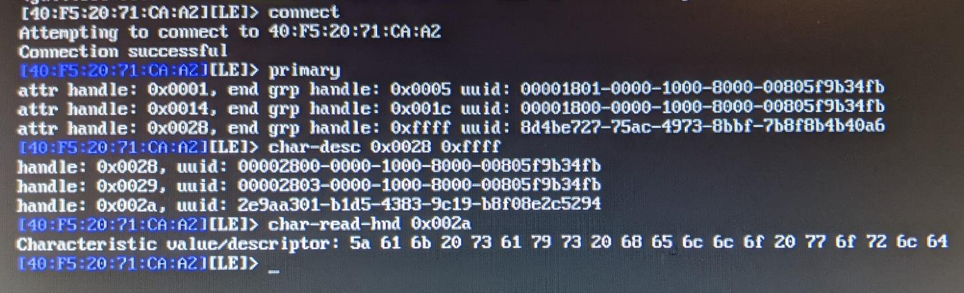
[picture p121: figure]

- INCOMPLETE. Successfully read data from the OBD-II port over Bluetooth

Testing the ELM327 requires most of the circuitry to be assembled already, and I do not have a multimeter yet to test all my components before connecting them. It was an oversight from the beginning of the term; I thought I could get more done than I really could. Now that I have actually made progress on the project, I will have be able to set more realistic goals going forward.

- INCOMPLETE. Successfully interpret data from the OBD-II port over Bluetooth

See above.

- INCOMPLETE. Successfully write data to the OBD-II port over Bluetooth

See above.
