ZR-OIT/senior-project/CST 472 - Winter/CST 472 work agreement updated results.pdf

Zak Rowland
CST 472
3/12/2020
Work agreement results
1. Test and confirm LEDs work using an external power supply or the ESP32 microcontroller

Completed Jan 11, 2021.

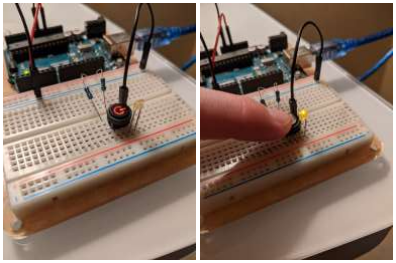
[picture p122: figure]

2. Assemble required power circuitry on breadboards, measure and record all relevant voltages

Completed Jan 16, 2021.

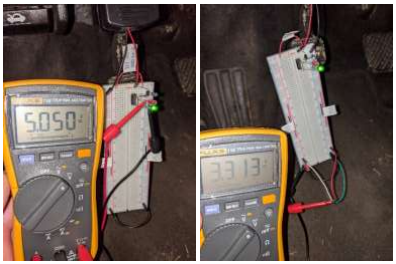
[picture p123: figure]

3/12/2020
Work agreement results
3. Finish assembling circuitry on breadboards

Completed Jan 23, 2021.

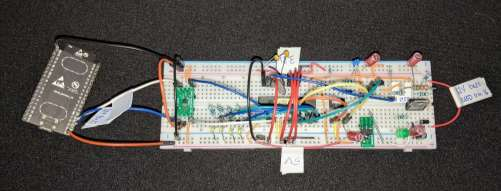
[picture p124: figure]

4. Test the ELM327 circuit by issuing the command to return the version number

Completed Jan 31, 2021.

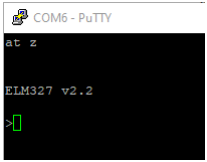
[picture p125: figure]

5. Read data from the OBD-II port with a physical connection

Completed Jan 31, 2021.

3/12/2020
Work agreement results

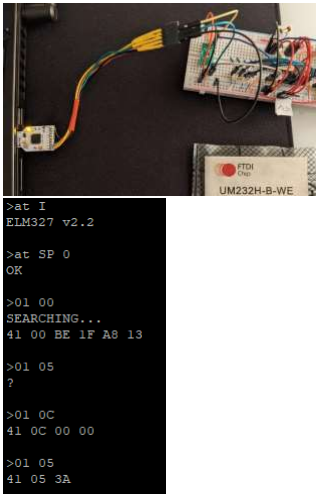
[picture p126: figure]

6. Interpret data from the OBD-II port with a physical connection

Completed Jan 31, 2021.

3/12/2020
Work agreement results


7. Write data to the OBD-II port with a physical connection

Completed Jan 31, 2021.

See image from #6 above.

3/12/2020
Work agreement results
8. Configure the Raspberry Pi to use the external power switch

Completed Feb 9, 2021.

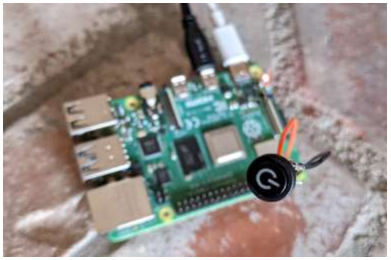
[picture p127: figure]

9. Properly configure Bluetooth connection between ESP32 and Raspberry Pi

Completed March 8, 2021.

3/12/2020
Work agreement results

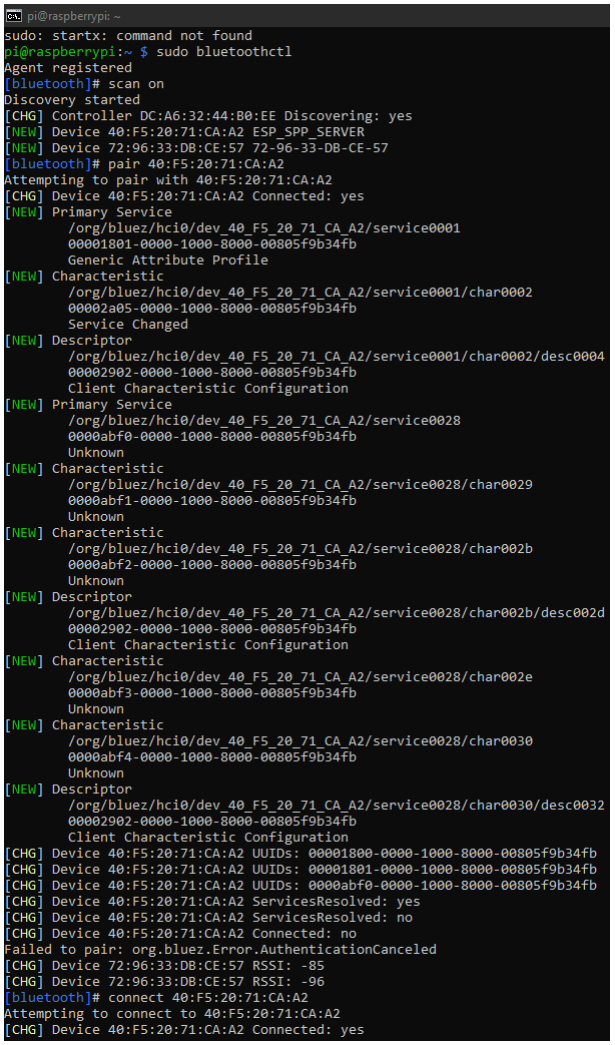
[picture p128: figure]

3/12/2020
Work agreement results

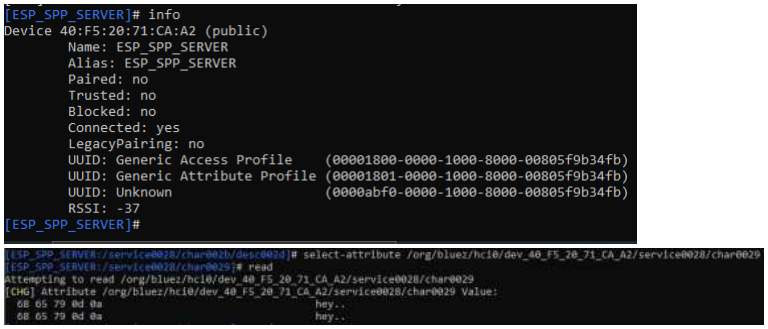
[picture p129: figure]

10. Read and interpret data from the OBD-II port over Bluetooth

Incomplete.

11. Write data to the OBD-II port over Bluetooth

Incomplete.

12. Implement ability to monitor battery voltage for Raspberry Pi

Incomplete.

13. Implement ability to read a diagnostic code

Incomplete.

14. Implement ability to read speed, temperatures, pressures, etc.

Incomplete.

9/14 or 64.28% complete.
