ZR-OIT/senior-project/CST 473 - Spring/Test Plan and Results/Test Plan and Results.xlsx

Test Plan and Result Template
Project Name | Wireless OBD-II Diagnostic Tool
Company Name | Oregon Institute of Technology
Engineer | Zak Rowland
Test Plan Date and update dates | June 4th, 2021
Requirement Number | Requirement Description | Percent Complete | Test methodology | Test Equipment | Special test condition | Test Disposition | Test Date | Test Trial No. | Associated test document | Test Notes
Requirement Number from requirements doc. | Requirement description from requirements document is listed here. If there are subrequirements list them as well. Some requirements have sub requirements. List the subrequirements as well. If a requirement has multiple tests, then add a new row for that test. | List pct complete | How was this requirement tested? Press ALT+ENTER for new line in Excel | List any test equipment used for the test | List any special conditions for your test | PASS, FAIL, PARTIAL PASS | List the planned date or run | List number of test attempts | List associated test documents here by file name indicating proof of successful test. Place the documents into the same folder as this template | List any notes
1 | The system shall work with the 2008 Nissan Altima OBD-II protocol, ISO15765-4 (CAN-BUS.) a. Other vehicles that use the same protocol may work with the system, however it is not required. | 100% | The OBD-II circuit was connected to the OBD-II port in a 2008 Nissan Altima. Using a serial to USB device, a connection was established between the OBD-II circuit and a laptop computer with PuTTY. After issuing the commands to automatically search for the vehicle protocol, the connection was established successfully. Data such as the VIN, engine RPM, and coolant temperature could be requested and decoded. | Multimeter, oscilloscope, serial to USB device, laptop computer, PuTTY | None | PASS | Jan. 31st, 2021 | 1 | Req. 1 - Decoded connection.jpg Req. 1 - Decoded connection 2.jpg | None
2 | The system shall be able to read and clear diagnostic (trouble) codes. a. The user interface will display the diagnostic codes in list form with buttons to scroll up and down through the list. i. The list will display the diagnostic codes (e.g. P0011) only. ii. The user must touch one of the diagnostic codes to read the description or possible cause. b. The user interface will provide a button to clear all diagnostic codes. | 33% | To test if the system can read and clear diagnostic codes, the commands to do so were issued. Although no diagnostic codes were present at the time, the system successfully returned the fact that there were none. Testing the user interface will involve tapping all on-screen buttons and ensuring features operate as intended. | None | None | PARTIAL PASS | June 1st, 2021 | 1 | None | GUI not finished
3 | The system shall have the ability to read sensor data at minimum 30 times per second including speed, coolant temperature, and oil pressure. a. The user interface will display the data in decimal format. i. The option for digital gauges may be implemented. b. The data will be displayed by default in units of miles per hour for speed, Fahrenheit for temperature, and pounds per square inch for pressure. i. The option for metric units shall be implemented. | 0% | To ensure the system is collecting data at least 30 times per second, the Bluetooth connection will be monitored to see how many times per second the different data values are updated. | None | None | FAIL | June 1st, 2021 | 1 | None | Bluetooth connection not finished
4 | The system shall use Bluetooth 4.0 or greater for data transfer. a. The Bluetooth version shall be 4.0 or greater because previous versions do not support Bluetooth Low Energy (BLE.) The range of the connection is also improved with newer versions. | 100% | To verify that the devices in the system are Bluetooth 4.0 or greater, the documentation of each can be observed. The Raspberry Pi 4B uses Bluetooth 5.0 and BLE. The ESP32 supports Bluetooth 4.2 and BLE. | None | None | PASS | Nov. 11th, 2020 | 1 | Req. 4 - raspberry-pi-4-product-brief.pdf Req. 4 - esp32_datasheet_en.pdf | None
5 | The Bluetooth transceiver circuit that interfaces with the OBD-II port shall be powered by the OBD-II port. a. A power circuit will be designed to ensure power from the port is reliable. | 100% | A multimeter was used to monitor the final voltages before connecting power to the ICs. The voltage levels appeared stable and successfully powered the circuit. If the power source was not working correctly, an oscilloscope could be used to monitor the signal in greater detail. | Multimeter, oscilloscope | None | PASS | Jan. 15th, 2021 | 1 | Req. 5 - 3.3V power.jpg Req. 5 - 5V power.jpg Req. 5 - 12V power.jpg | None
6 | The handheld unit shall use a touchscreen to display information and receive user input. a. The touchscreen of the handheld unit shall be 3.5” or greater diagonally. b. The touchscreen of the handheld unit shall operate at a resolution of at least 320 x 480 pixels. | 100% | To ensure the size and resolution of the touchscreen meets requirements, the datasheet from the manufacturer can be observed. The screen used is 5" and has a resolution of 800x480. | None | None | PASS | Nov. 11th, 2020 | 1 | Req. 6 - 5inch-dsi-v2screen.pdf | None
7 | The user interface shall not require multi-touch or swiping. a. Operation with single presses simplifies the user interface and is more accessible to those with disabilities. b. The option to scroll through a list by swiping up or down may be implemented. | 100% | The user interface should be thourougly tested to ensure all on-screen buttons function and nothing requires swiping or multi-touch. Every button such as scrolling up or down, settings, and selecting a code should be tapped. | None | None | PASS | June 1st, 2021 | 1 | Req. 7 - Touchscreen GUI.jpg | None
8 | The rechargeable battery shall be recharged via a USB-C port. | 100% | To make sure the system is recharged with USB-C, the prefabricated charging module or the designed recharging circuit should have been designed to incorporate USB-C. The rechargeable battery module used in the system uses this version of USB, which can be verified in the datasheet. | None | None | PASS | Nov. 11th, 2020 | 1 | Req. 8 and 9 - Raspberry Pi UPS pack.pdf | None
9 | The rechargeable battery shall power for the handheld unit at full load for at least 2 hours. a. The rechargeable battery must include protection and charging circuitry. | 50% | To test how long the rechargeable battery can power the handheld unit, the ESP32 will be powered by a computer and a Bluetooth connection will be established. With a timer, the running time will be measured with the handheld device constantly transferring Bluetooth data with the screen at full brightness. To ensure the rechargeable battery includes proper protection and charging circuitry, the datasheet for the module can be observed. | Computer, timer | None | PARTIAL PASS | June 1st, 2021 | 1 | Req. 8 and 9 - Raspberry Pi UPS pack.pdf | Since the Bluetooth connection and GUI was not finished, the actual time cannot be measured.
10 | The charge level of the rechargeable battery shall be displayed on the user interface. a. The charge level will be displayed as a percentage, 100% being fully charged. | 0% | Once the user interface is finished, verify that there is a battery percentage presented on-screen. | None | None | FAIL | June 1st, 2021 | 1 | None | GUI not finished
11 | The brightness level of the touchscreen shall be adjustable in the user interface in 10% increments, 100% being maximum brightness. | 0% | Once the user interface is finished, verify that the brightness can be adjusted in 10% increments by tapping the appropriate buttons and ensuring the brightness changes each time. | None | None | FAIL | June 1st, 2021 | 1 | None | GUI not finished
12 | The handheld unit shall include a physical ON/OFF power switch. | 100% | To test the physical ON/OFF switch, press the button when the Raspberry Pi is off to verify it boots up. When the Raspberry Pi is on, press the button again to very it shuts down. | None | None | PASS | Feb. 9th, 2021 | 1 | None | None
13 | The system shall use a single board computer or microcontroller. | 100% | Verify the system uses either a single board computer or microcontroller by viewing the schematics. The system includes both a single board computer (Raspberry Pi 4b) and a microcontroller (ESP32). | None | None | PASS | Nov. 11th, 2020 | 1 | Req. 13 - Handheld Transceiver Schematic.pdf Req. 13 - OBD-II Trancseiver Schematic Rev1.1.pdf | None
14 | The code and documentation developed shall be open source. | 100% | Upon project completion, verify that all code and documentation is inside a public respository. | None | None | PASS | June 1st, 2021 | 1 | None | None
