ZR-OIT/senior-project/CST 472 - Winter/images/3-8-2021 testing ble from phone.png

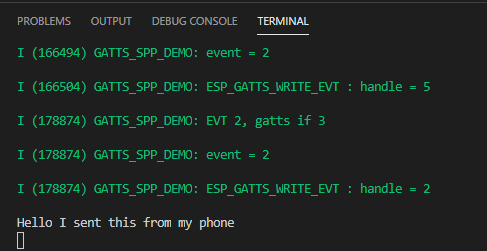
CST 472 - Winter/images/3-8-2021 testing ble from phone.png
