ZR-OIT/senior-project/CST 472 - Winter/images/Trello before changes 1-11-2021.png

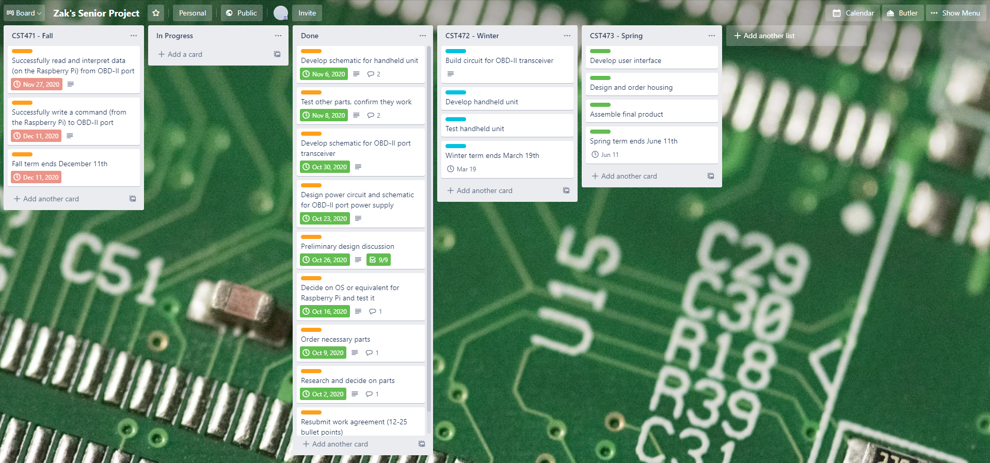
CST 472 - Winter/images/Trello before changes 1-11-2021.png
