ZR-OIT/senior-project/CST 471 - Fall/Handheld Transceiver Schematic.pdf

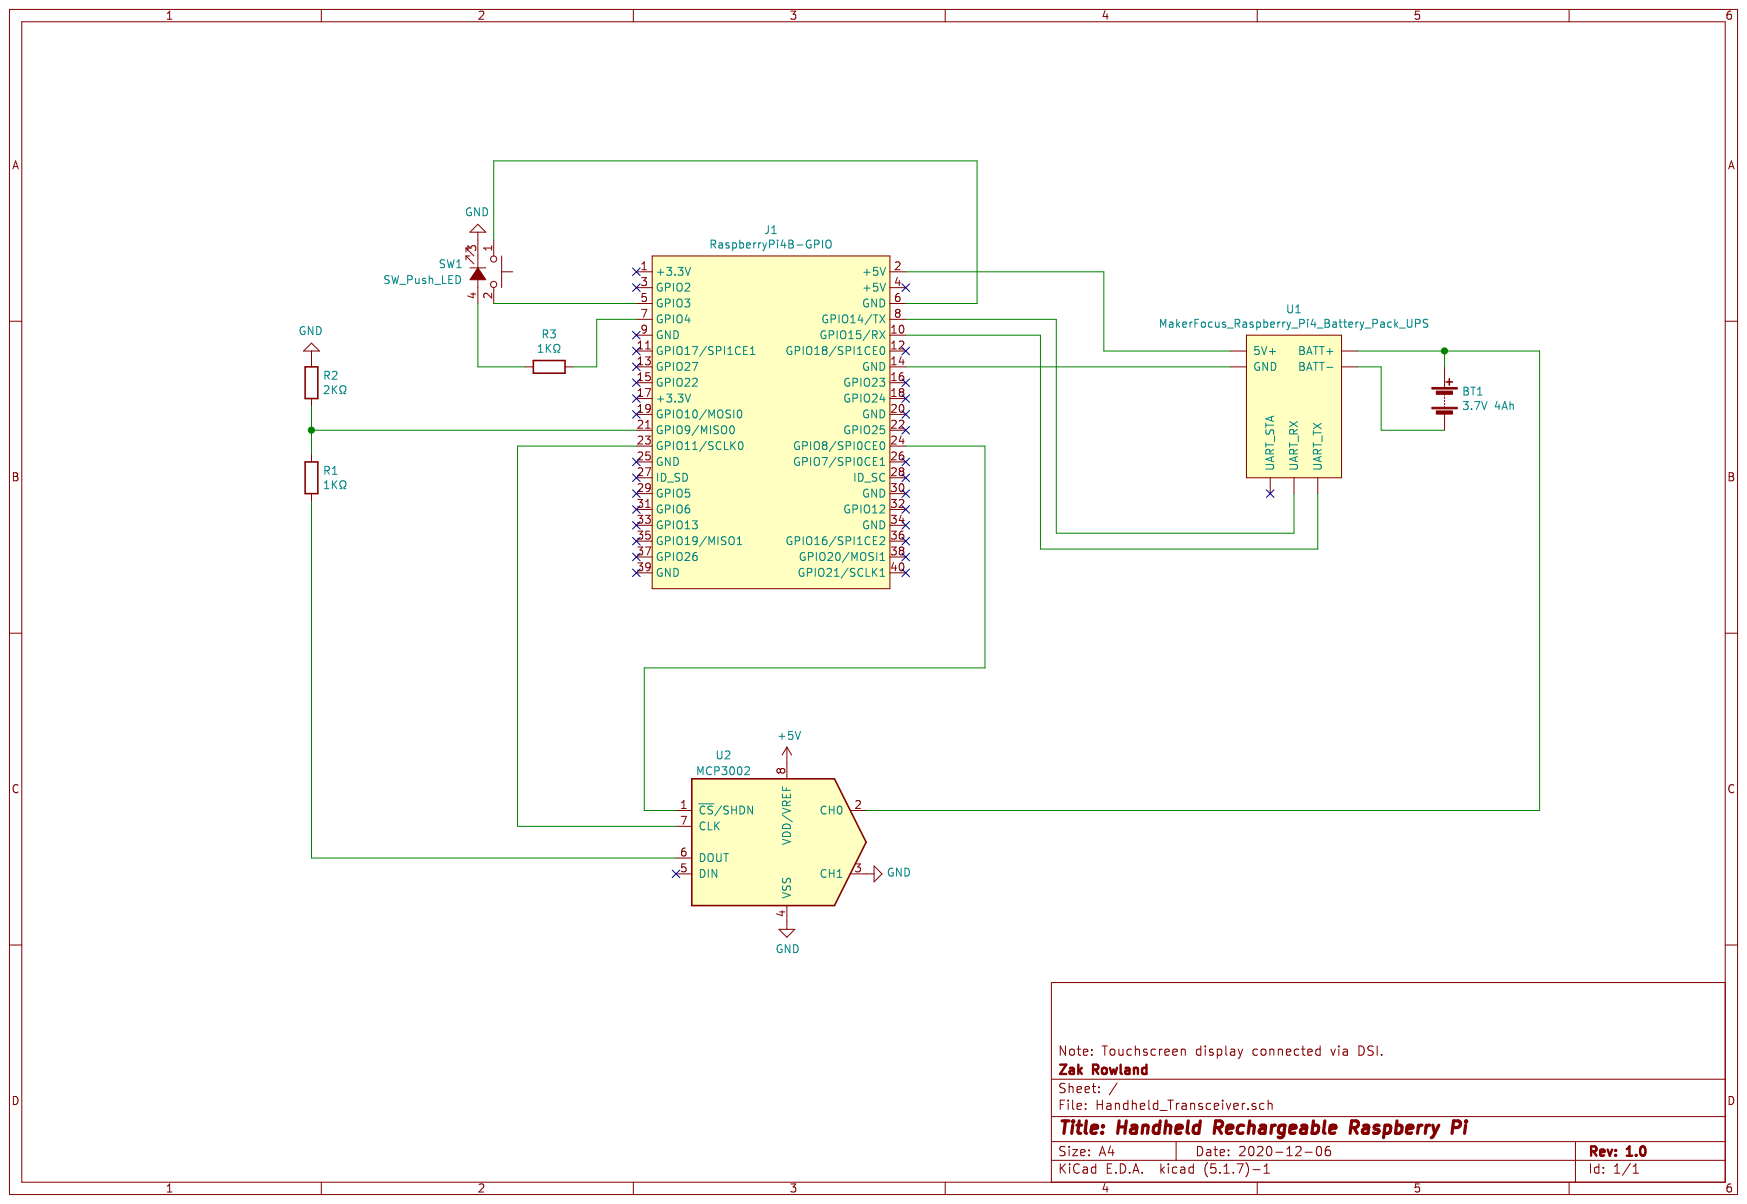
[picture p133: page 1]
