ZR-OIT/senior-project/CST 471 - Fall/OBD-II Trancseiver Schematic.pdf

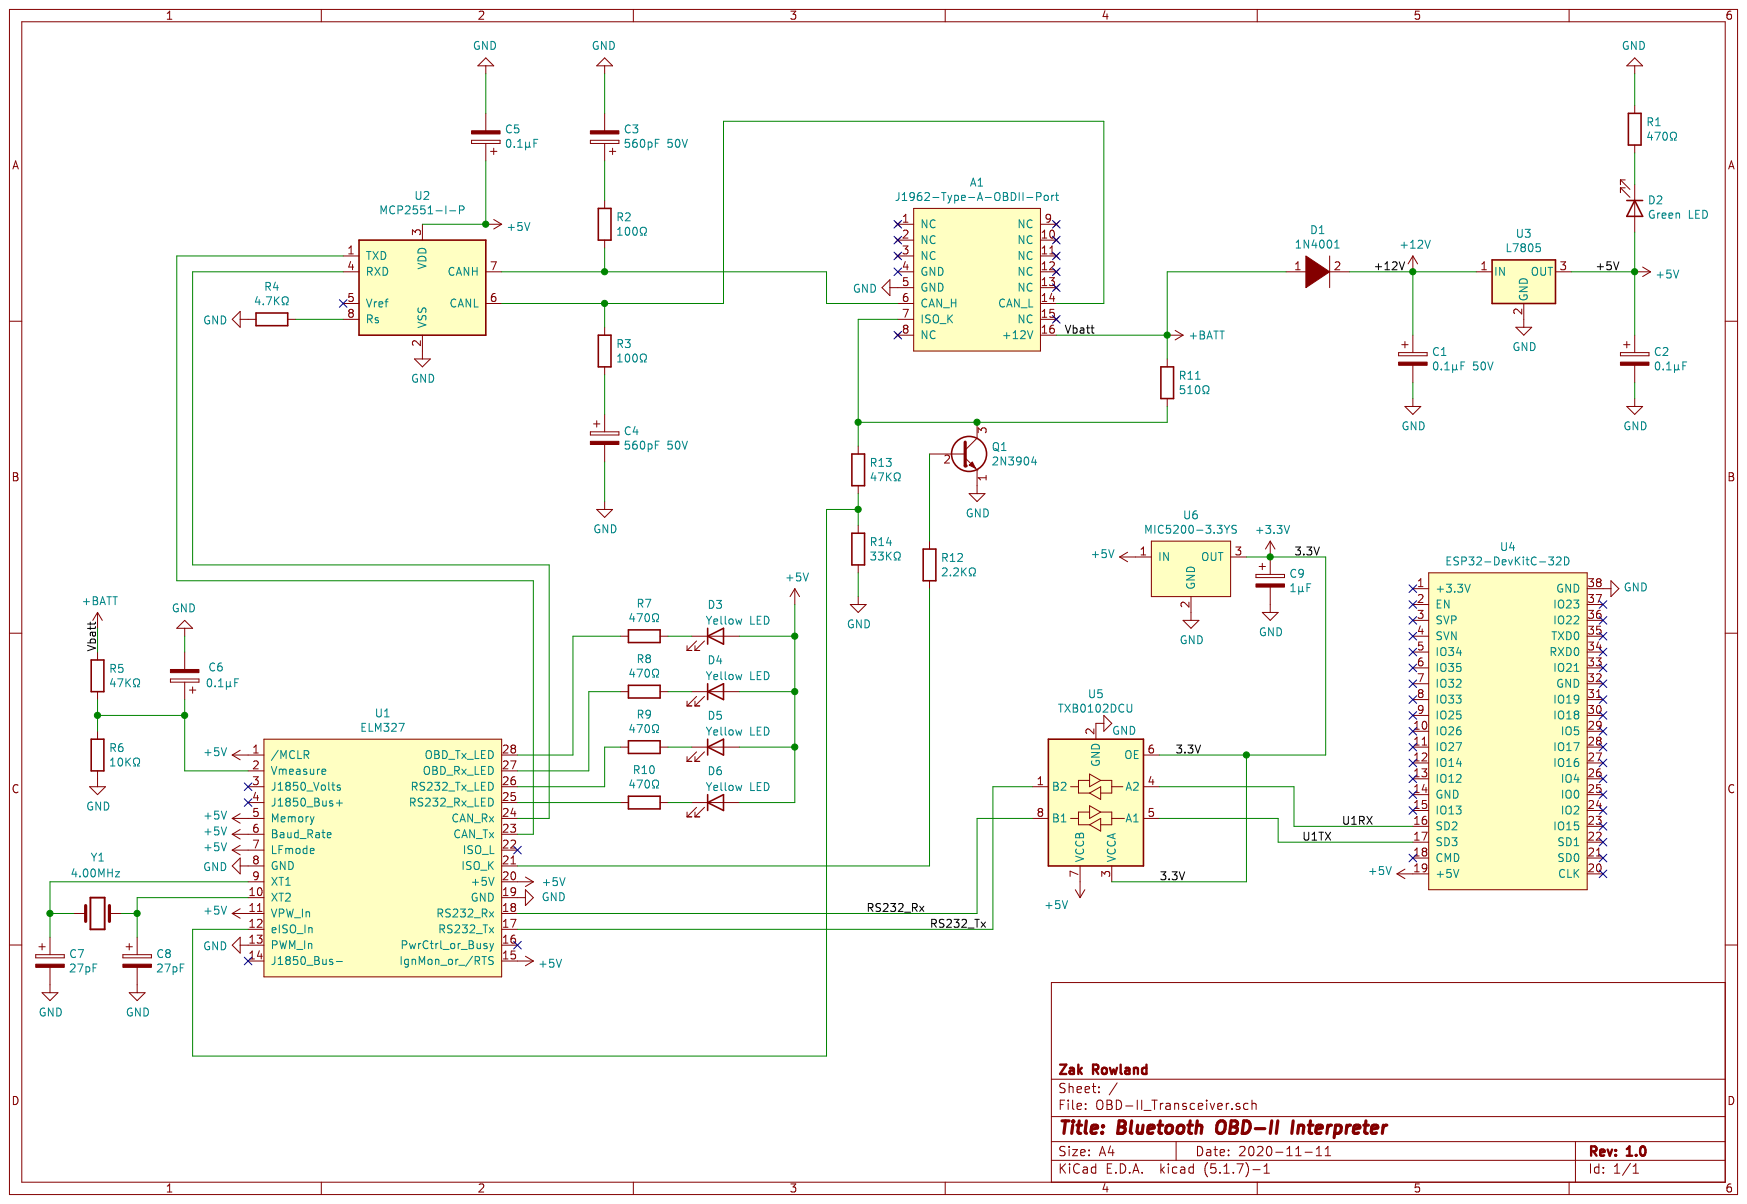
[picture p134: page 1]
