ZR-OIT/senior-project/CST 472 - Winter/OBD-II Trancseiver Schematic Rev1.1.pdf

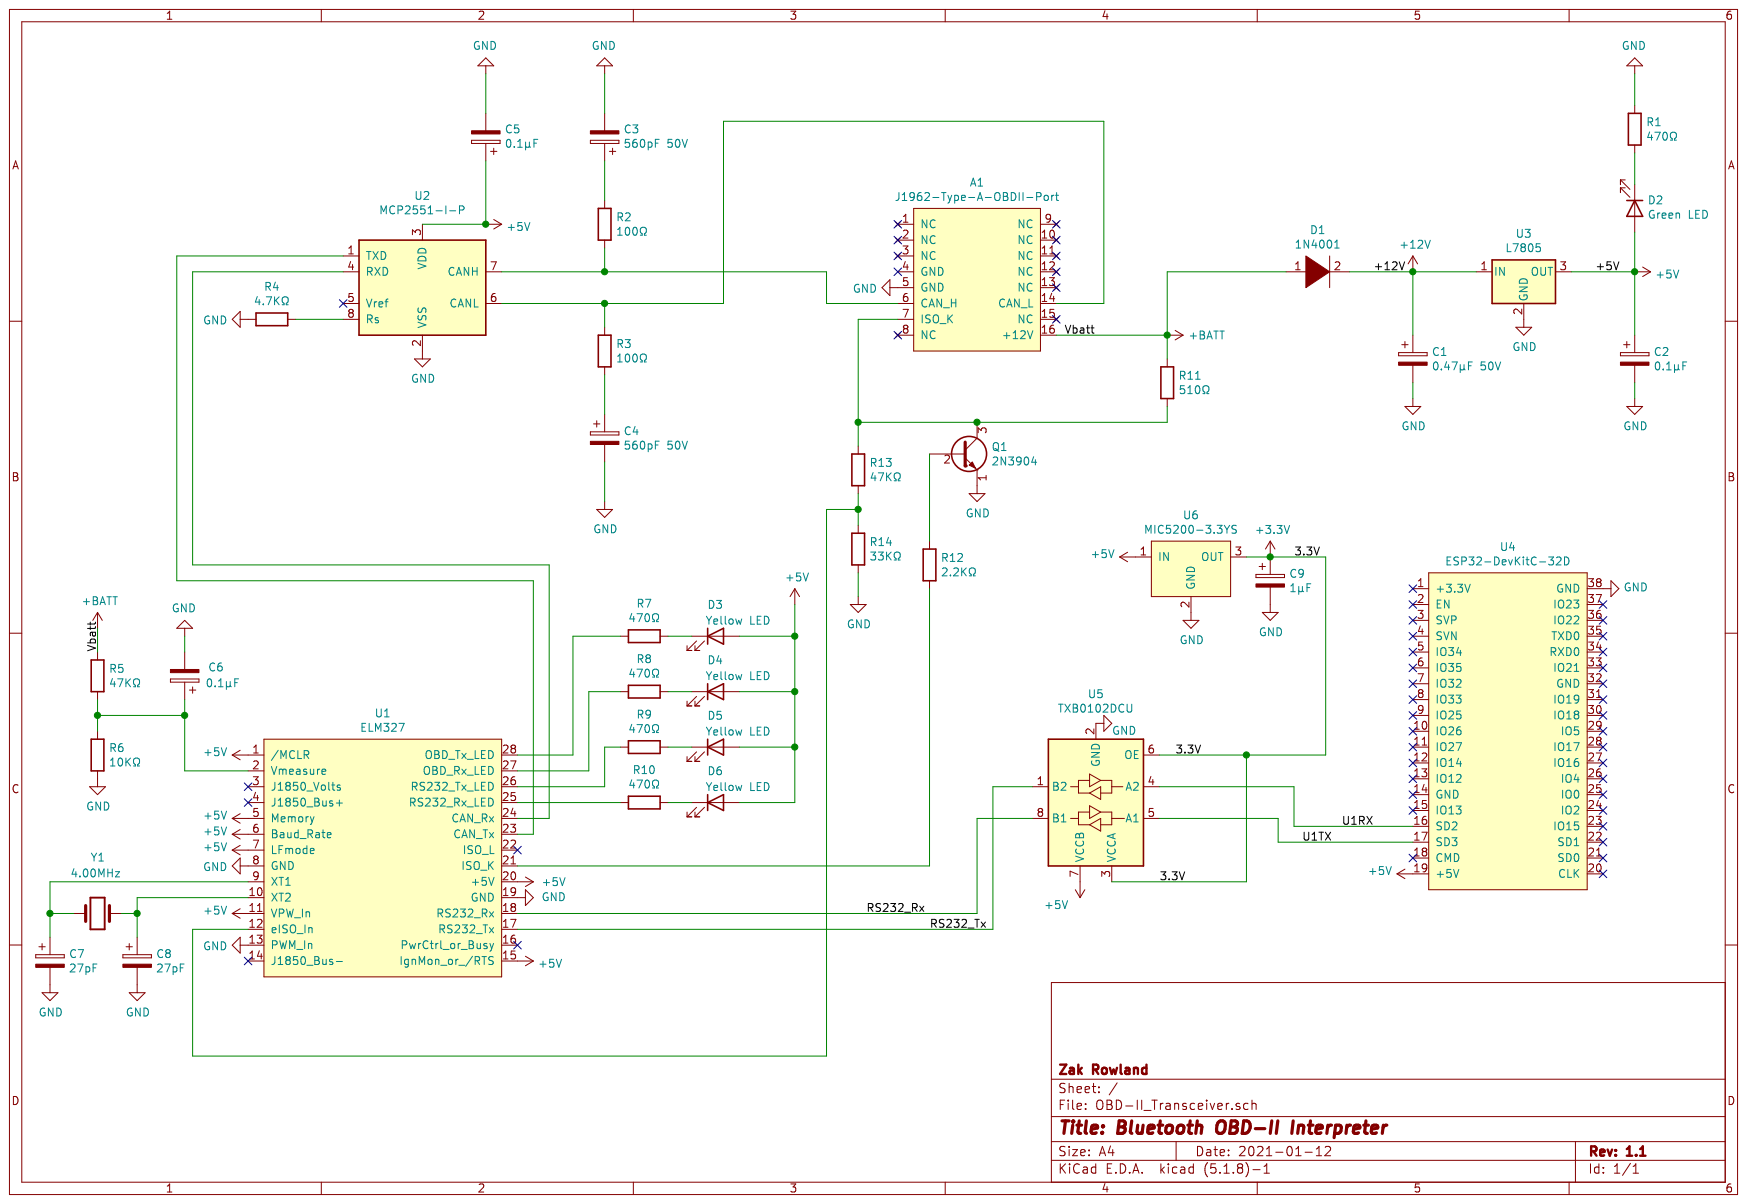
[picture p135: page 1]
