ZR-OIT/senior-project/CST 473 - Spring/Test Plan and Results/Results/Req. 6 - 5inch-dsi-v2screen.pdf

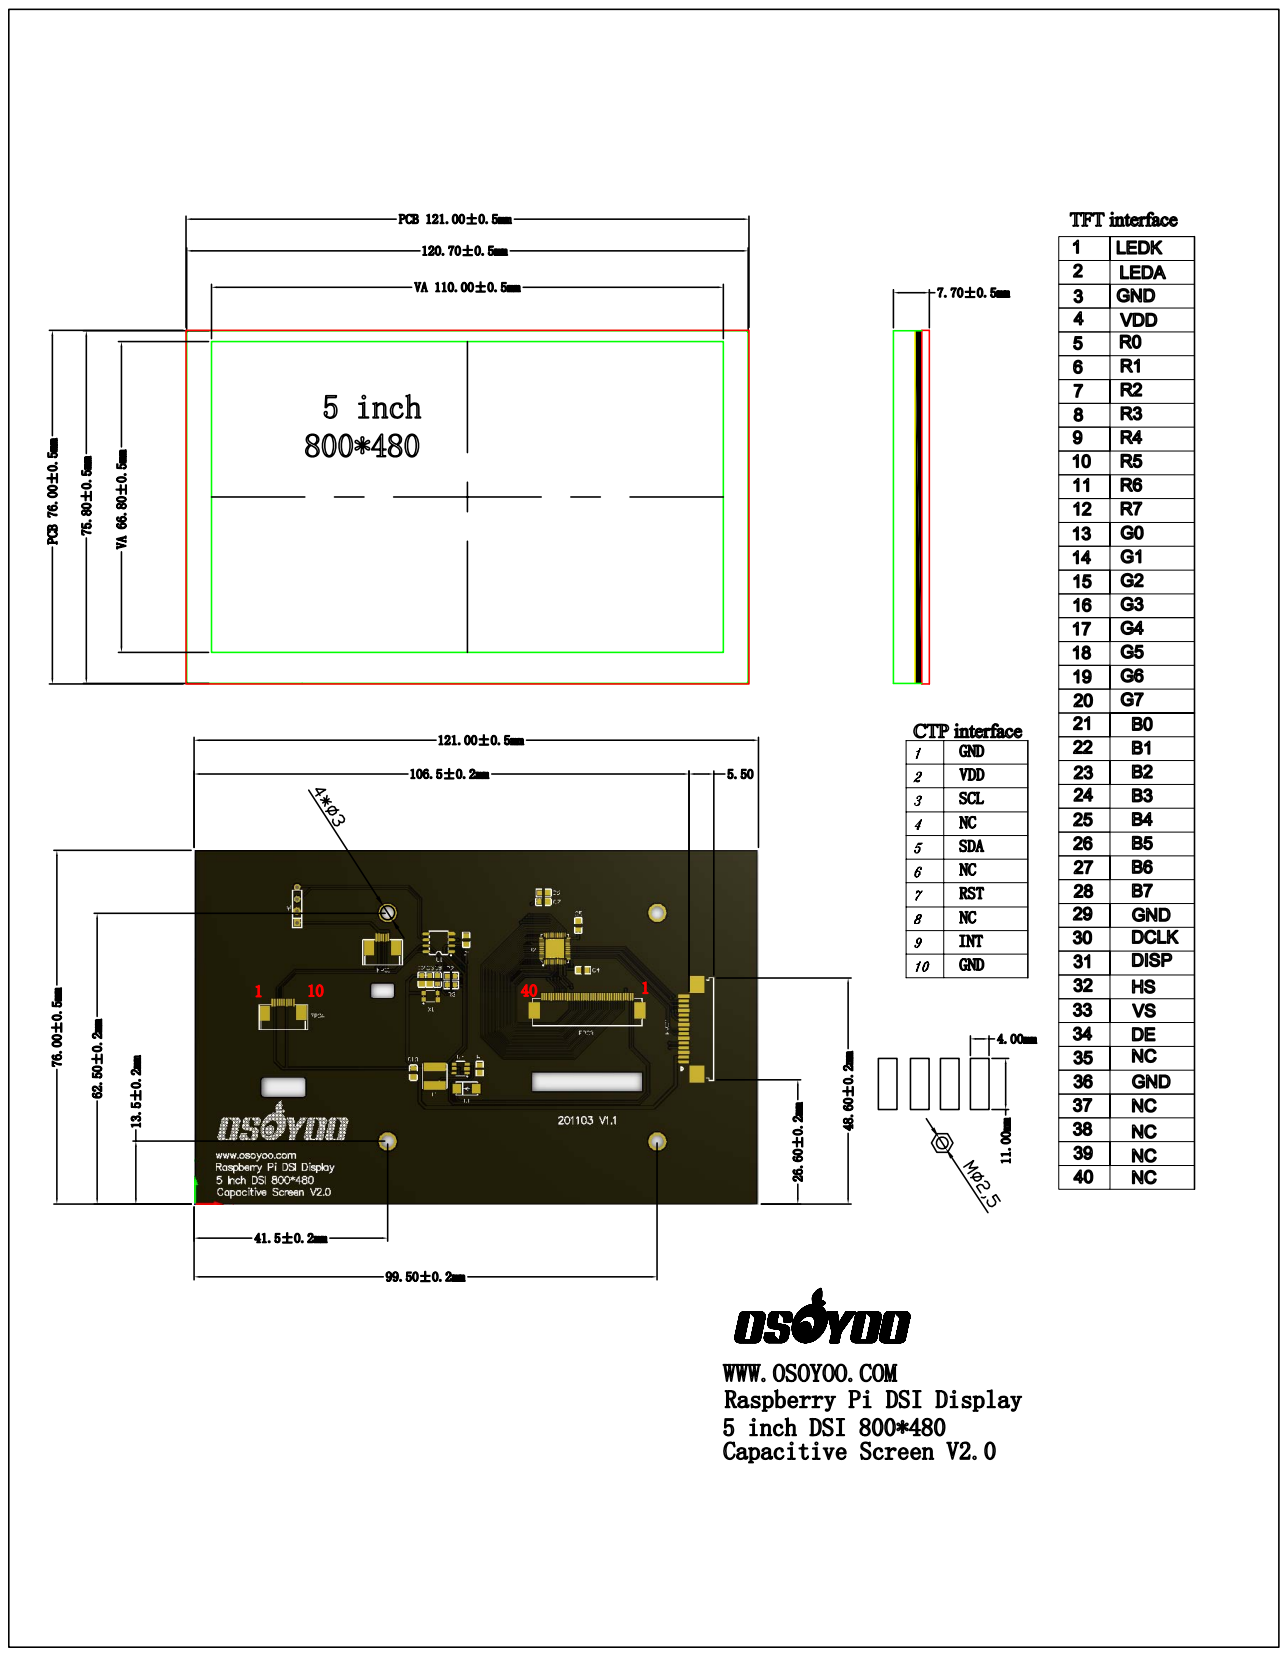
[picture p136: page 1]
