ZR-OIT/senior-project/CST 472 - Winter/images/PXL_20210112_044957542.jpg

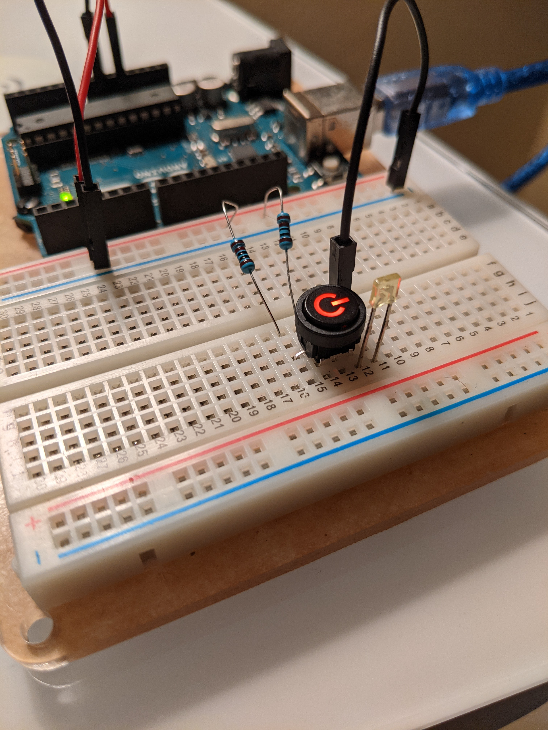
CST 472 - Winter/images/PXL_20210112_044957542.jpg
