ZR-OIT/senior-project/CST 472 - Winter/images/PXL_20210113_003018603.jpg

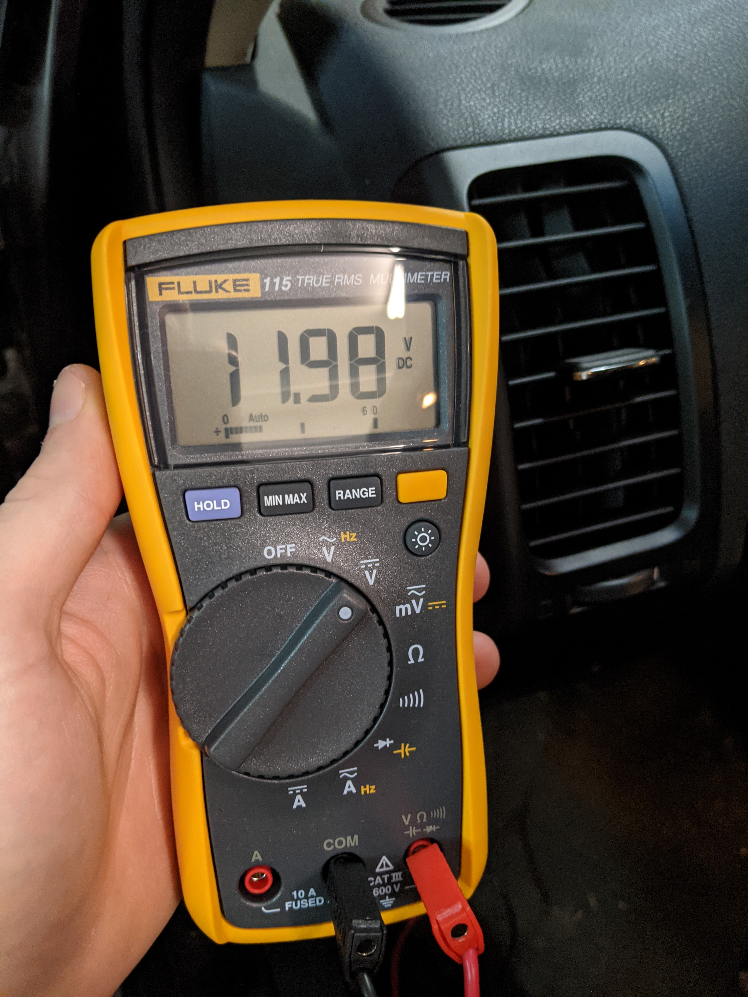
CST 472 - Winter/images/PXL_20210113_003018603.jpg
