ZR-OIT/senior-project/CST 472 - Winter/images/PXL_20210113_003230547.jpg

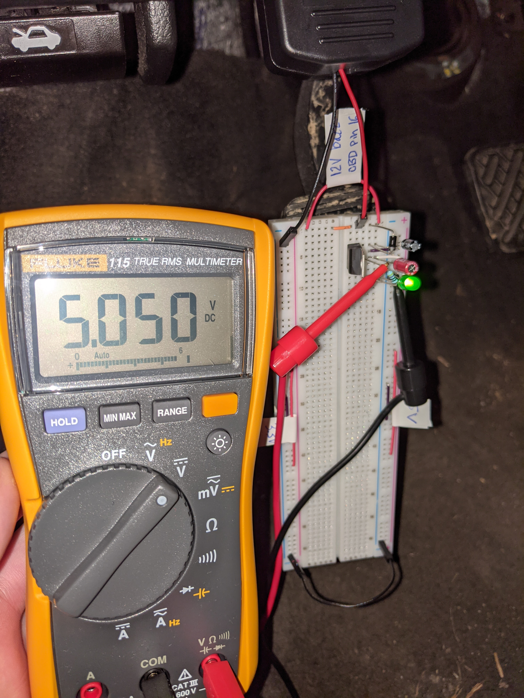
CST 472 - Winter/images/PXL_20210113_003230547.jpg
