ZR-OIT/senior-project/CST 472 - Winter/images/PXL_20210117_001518523.jpg

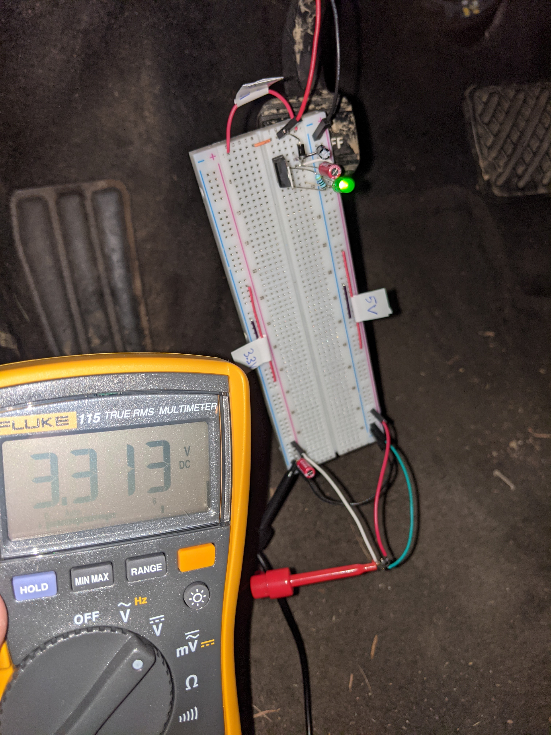
CST 472 - Winter/images/PXL_20210117_001518523.jpg
