ZR-OIT/senior-project/CST 472 - Winter/images/PXL_20210124_014826517.jpg

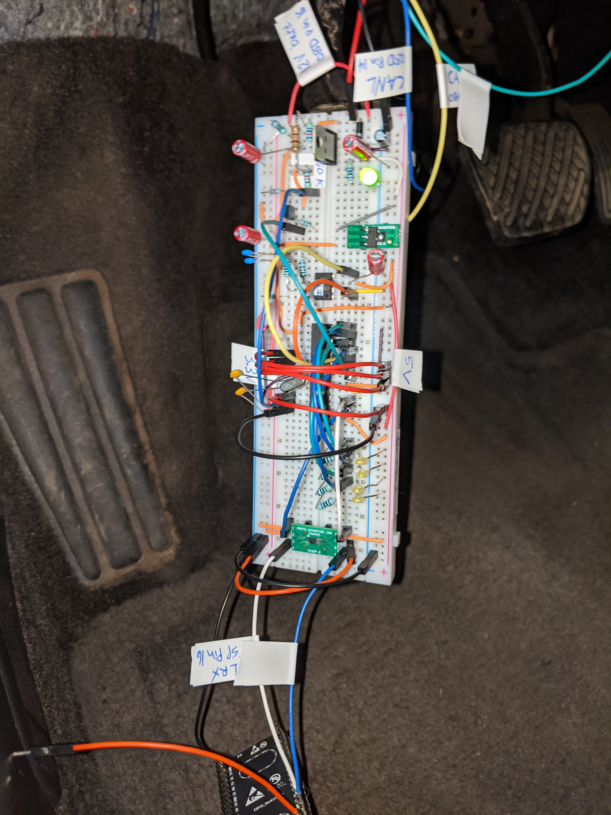
CST 472 - Winter/images/PXL_20210124_014826517.jpg
