ZR-OIT/senior-project/CST 472 - Winter/images/3-8-2021-UPSPack-soldered.jpg

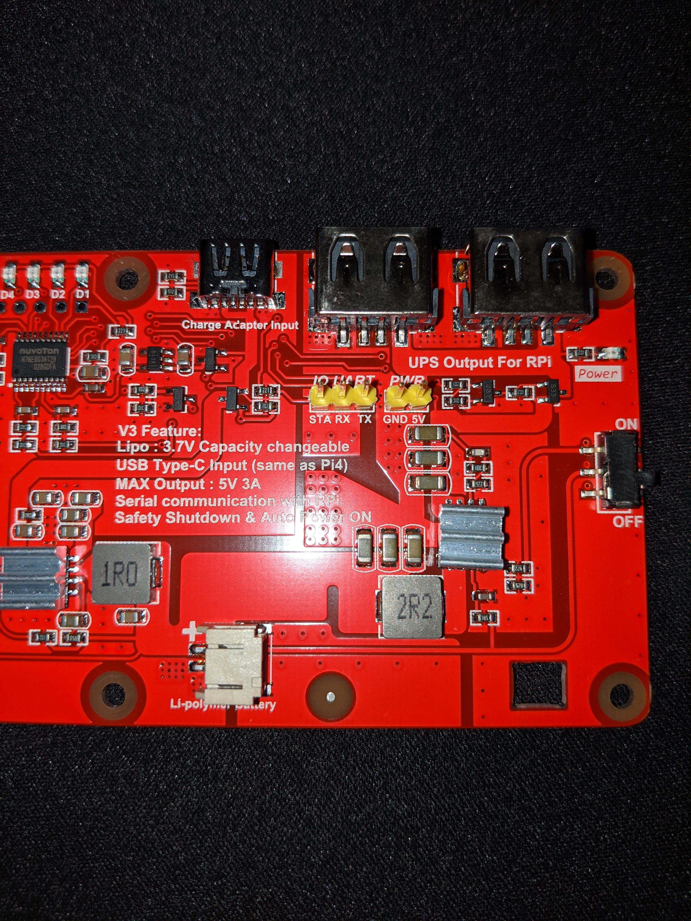
CST 472 - Winter/images/3-8-2021-UPSPack-soldered.jpg
